DavidBorsky/NODI-Robotic-Alarm-Clock/Analysis/actuator_torque_analysis.pdf

0.00 | 0.01 | 0.02 | 0.03 | 0.04 | 0.05
| | | Torque [N·m]

### Pitch demand (SF = 2)

### Yaw demand (SF = 2)

### Assumed operating budget

0.0347 N·m

0.0136 N·m

0.0441 N·m

## Actuator sizing — analytical screening

Budget = 25% of MG90S 4.8 V stall torque; designer assumption, not a continuous rating. CAD mass +25%, 5 g head wiring, 10 mm CG offset, 180°/s². No hardware test.
