DavidBorsky/NODI-Robotic-Alarm-Clock/Analysis/command_motion_profiles.pdf

−20

0

20

### Angle [°]

# Full-travel quintic command profiles — calculated

0

20

40

60

### Velocity [°/s]

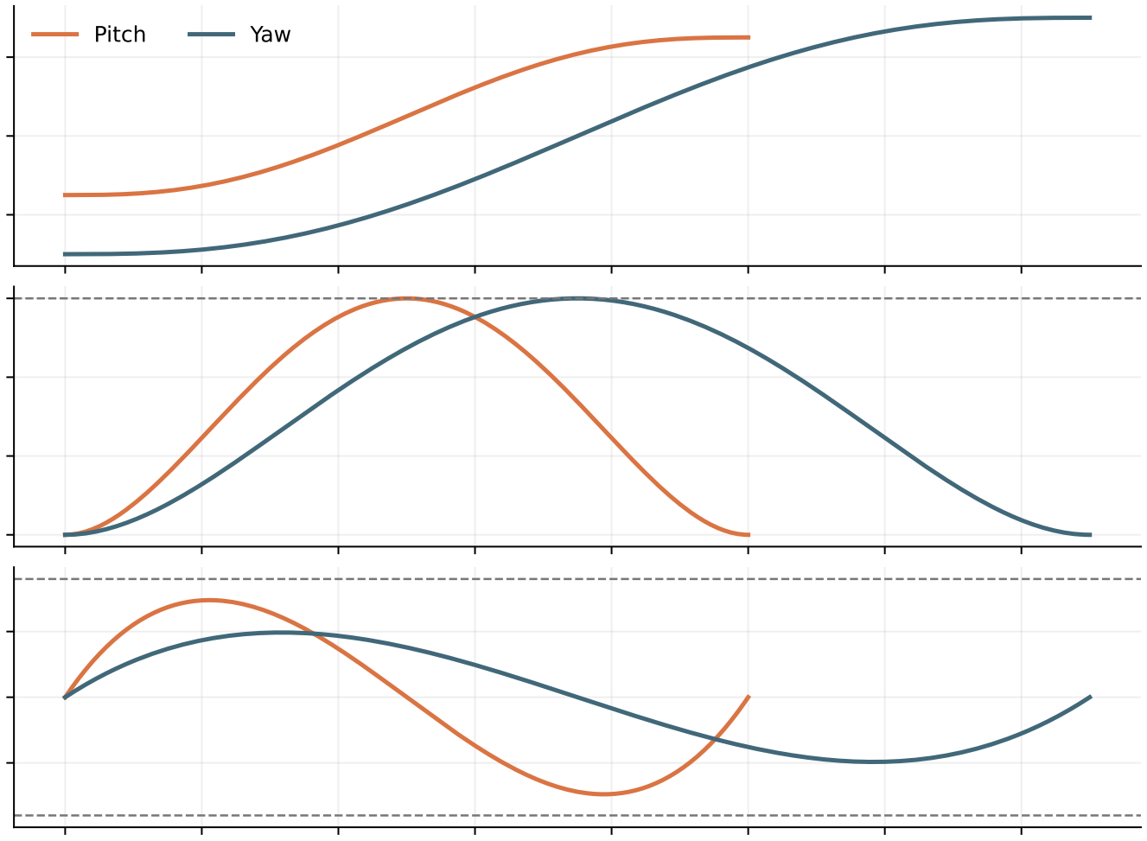
[picture p9: figure]
Pitch; Yaw

0.00 | 0.25 | 0.50 | 0.75 | 1.00 | 1.25 | 1.50 | 1.75
| | | | Time [s]

−100

0

100

### Acceleration [°/s²]

Command trajectories only. Loaded servo position, speed, backlash and current remain unmeasured.
