DavidBorsky/NODI-Robotic-Alarm-Clock/CAD/Kinematics/solver_motion.csv

frame | time_s | yaw_deg | yaw_origin_error_mm | yaw_axis_error_deg | pitch_deg | pitch_origin_error_mm | pitch_axis_error_deg | phase
1 | 0.0 | 0.0 | 0.0 | 0.0 | 0.0 | 0.0 | 0.0 | Neutral
2 | 0.016666666666666666 | 0.0 | 0.0 | 0.0 | 0.0 | 0.0 | 0.0 | Neutral
3 | 0.03333333333333333 | 0.0 | 0.0 | 0.0 | 0.0 | 0.0 | 0.0 | Neutral
4 | 0.05 | 0.0 | 0.0 | 0.0 | 0.0 | 0.0 | 0.0 | Neutral
5 | 0.06666666666666667 | 0.0 | 0.0 | 0.0 | 0.0 | 0.0 | 0.0 | Neutral
6 | 0.08333333333333333 | 0.0 | 0.0 | 0.0 | 0.0 | 0.0 | 0.0 | Neutral
7 | 0.1 | 0.0 | 0.0 | 0.0 | 0.0 | 0.0 | 0.0 | Neutral
8 | 0.11666666666666667 | 0.0 | 0.0 | 0.0 | 0.0 | 0.0 | 0.0 | Neutral
9 | 0.13333333333333333 | 0.0 | 0.0 | 0.0 | 0.0 | 0.0 | 0.0 | Neutral
10 | 0.15 | 0.0 | 0.0 | 0.0 | 0.0 | 0.0 | 0.0 | Neutral
11 | 0.16666666666666666 | 0.0 | 0.0 | 0.0 | 0.0 | 0.0 | 0.0 | Neutral
12 | 0.18333333333333332 | 0.0 | 0.0 | 0.0 | 0.0 | 0.0 | 0.0 | Neutral
13 | 0.2 | 0.0 | 0.0 | 0.0 | 0.0 | 0.0 | 0.0 | Neutral
14 | 0.21666666666666667 | 0.0 | 0.0 | 0.0 | 0.0 | 0.0 | 0.0 | Neutral
15 | 0.23333333333333334 | 0.0 | 0.0 | 0.0 | 0.0 | 0.0 | 0.0 | Neutral
16 | 0.25 | 0.0 | 0.0 | 0.0 | 0.0 | 0.0 | 0.0 | Neutral
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
