DavidBorsky/NODI-Robotic-Alarm-Clock/Images/actuator_torque_analysis.png

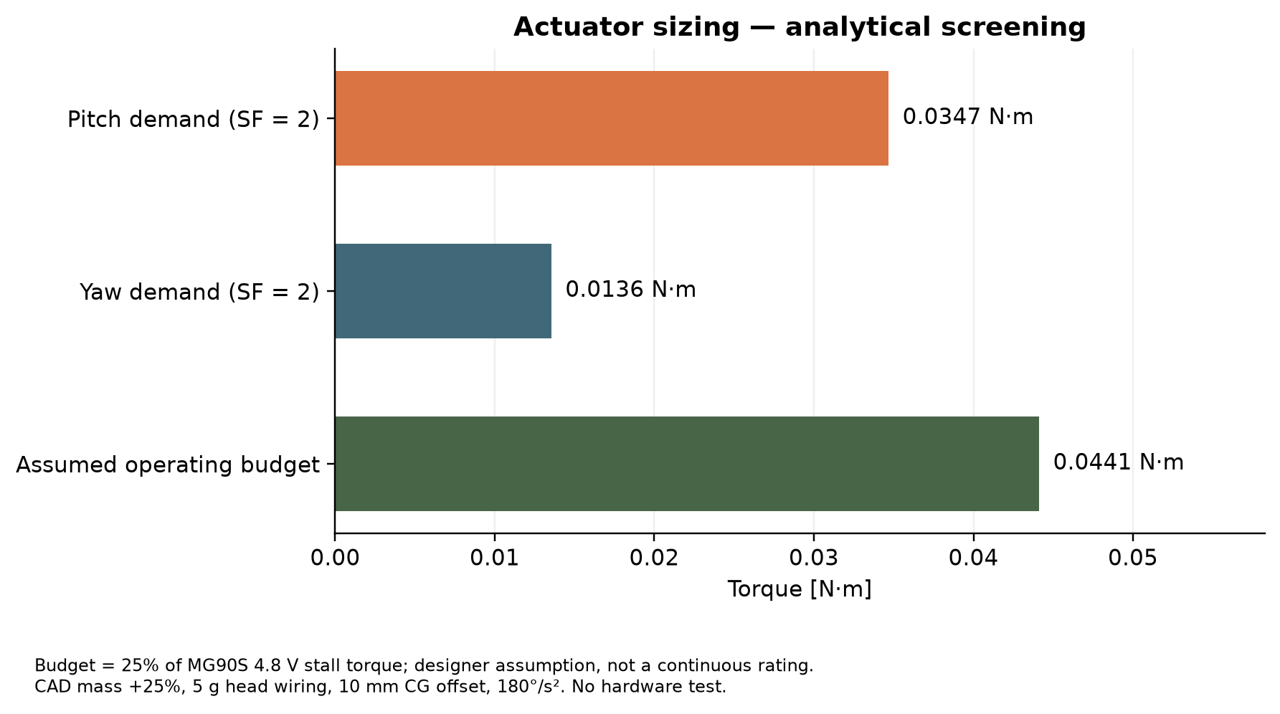
Images/actuator_torque_analysis.png
