DavidBorsky/NODI-Robotic-Alarm-Clock/Images/command_motion_profiles.png

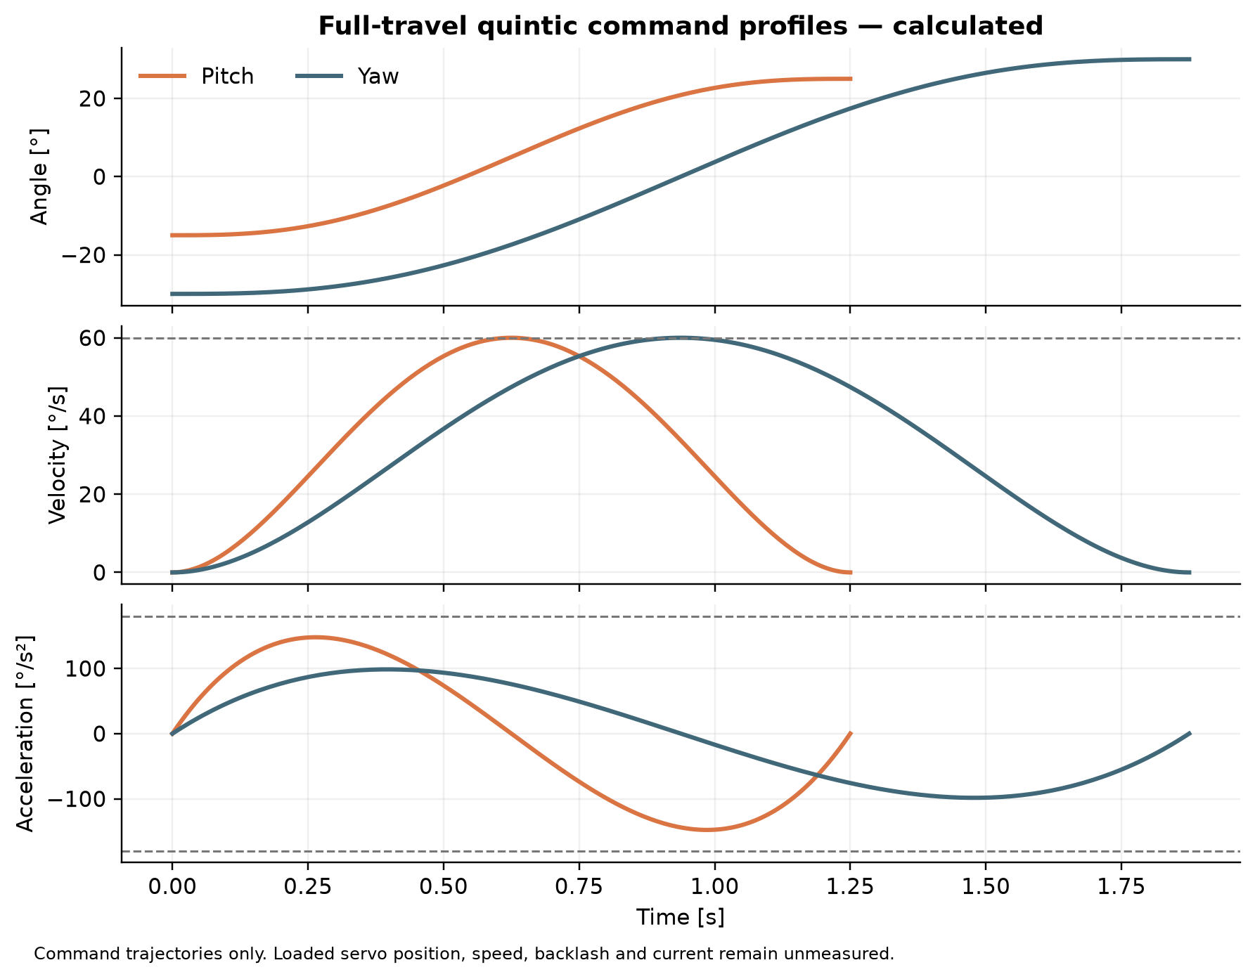
Images/command_motion_profiles.png
