DavidBorsky/NODI-Robotic-Alarm-Clock/Images/nodi_cheerful.png

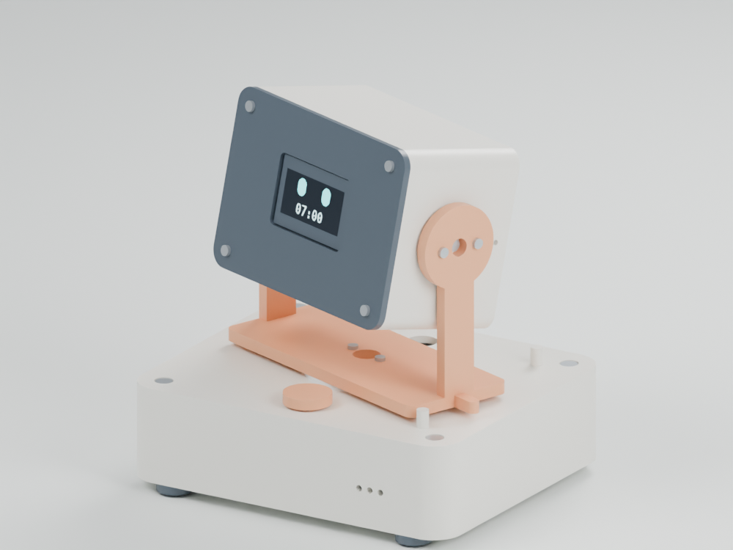
Images/nodi_cheerful.png
