DavidBorsky/NODI-Robotic-Alarm-Clock/Images/nodi_cutaway.png

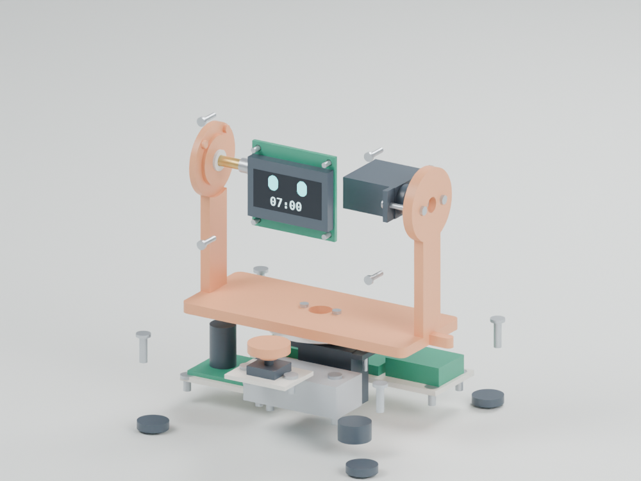
Images/nodi_cutaway.png
