DavidBorsky/NODI-Robotic-Alarm-Clock/Images/nodi_top.png

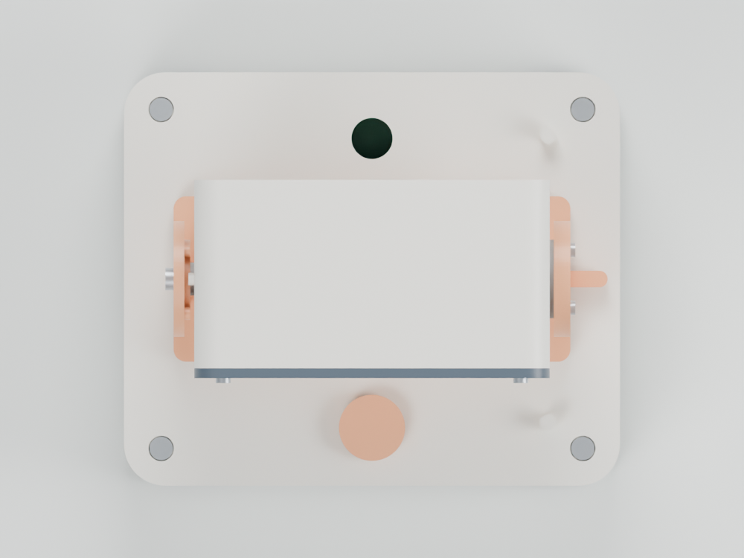
Images/nodi_top.png
