DavidBorsky/NODI-Robotic-Alarm-Clock/CAD/exports/NODI_Assembly_RevA.step

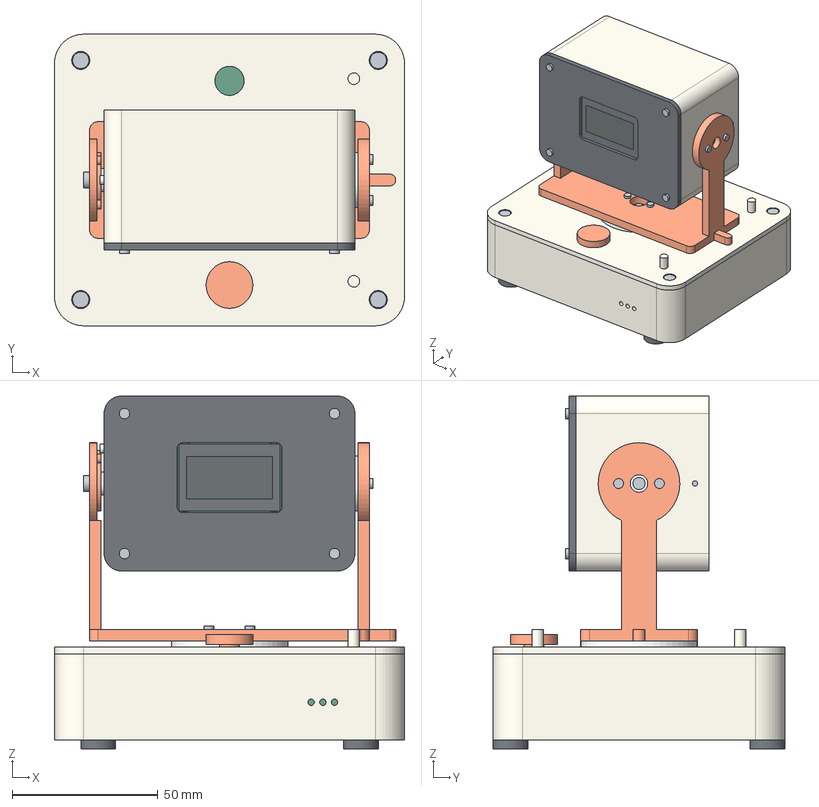
[picture p15: CAD file, 2026-10-25]
CAD/exports/NODI_Assembly_RevA.step
120.0 x 100.0 x 121.0 mm
base_cup
base_deck
thrust_washer
yoke
head_shell
front_bezel
pan_servo
tilt_servo
pan_horn
tilt_horn
pan_retaining_screw
tilt_retaining_screw
pitch_sleeve
pitch_washer
pitch_bolt
pitch_nut
oled_pcb
oled_panel
oled_active
rear_carrier
power_carrier
pico
rtc
power_perfboard
capacitor
buffer_ic
switch_carrier
snooze_switch
snooze_cap
piezo
foot_1
foot_2
foot_3
foot_4
ballast
ballast_screw_1
ballast_screw_2
deck_screw_1
deck_screw_2
deck_screw_3
deck_screw_4
bezel_screw_1
bezel_screw_2
bezel_screw_3
bezel_screw_4
oled_screw_1
oled_screw_2
oled_screw_3
oled_screw_4
pan_mount_screw_1
pan_mount_screw_2
tilt_mount_screw_1
tilt_mount_screw_2
pan_horn_screw_1
pan_horn_screw_2
tilt_horn_screw_1
tilt_horn_screw_2
rear_screw_1
rear_screw_2
rear_screw_3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
