DavidBorsky/NODI-Robotic-Alarm-Clock/CAD/exports/STL/NODI-P02_base_deck.stl

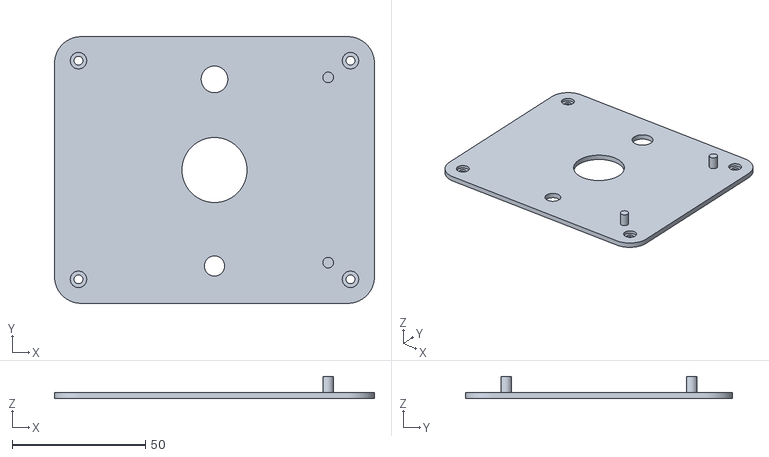
[picture p16: CAD file, 2026-10-25]
CAD/exports/STL/NODI-P02_base_deck.stl
120.0 x 100.0 x 8.40
