DavidBorsky/NODI-Robotic-Alarm-Clock/CAD/exports/STEP/snooze_switch.step

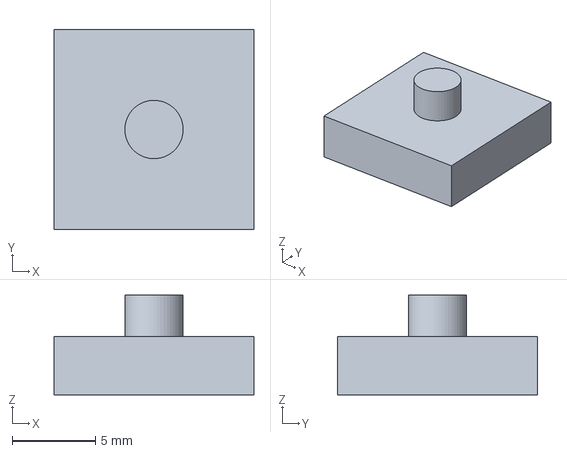
[picture p18: CAD file, 2026-10-25]
CAD/exports/STEP/snooze_switch.step
12.0 x 12.0 x 6.00 mm
