DavidBorsky/NODI-Robotic-Alarm-Clock/CAD/exports/STL/NODI-P06_rear_carrier.stl

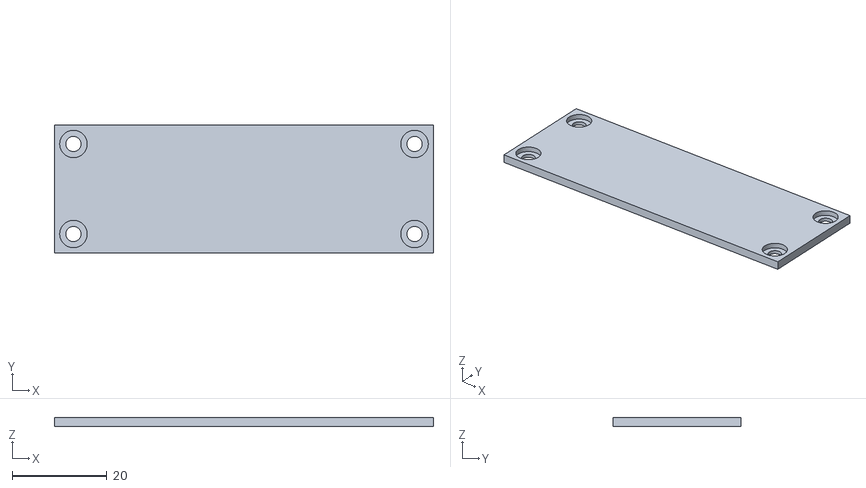
[picture p19: CAD file, 2026-10-25]
CAD/exports/STL/NODI-P06_rear_carrier.stl
80.0 x 27.0 x 2.00
