DavidBorsky/NODI-Robotic-Alarm-Clock/CAD/exports/meshes/tilt_servo.stl

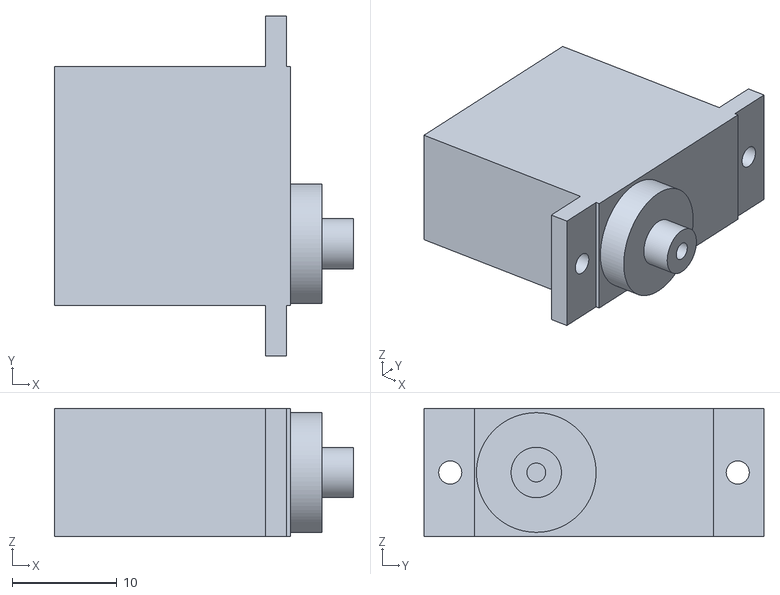
[picture p20: CAD file, 2026-10-25]
CAD/exports/meshes/tilt_servo.stl
28.5 x 32.4 x 12.2
