DavidBorsky/NODI-Robotic-Alarm-Clock/CAD/exports/STEP/power_perfboard.step

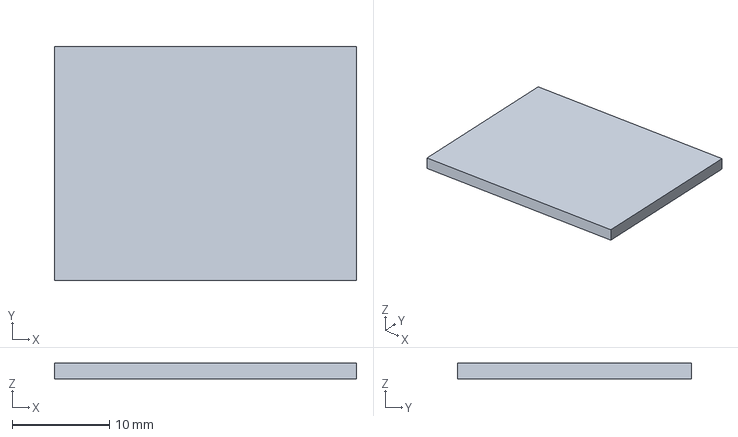
[picture p21: CAD file, 2026-10-25]
CAD/exports/STEP/power_perfboard.step
31.0 x 24.0 x 1.60 mm
