DavidBorsky/NODI-Robotic-Alarm-Clock/CAD/exports/STL/NODI-P09_snooze_cap.stl

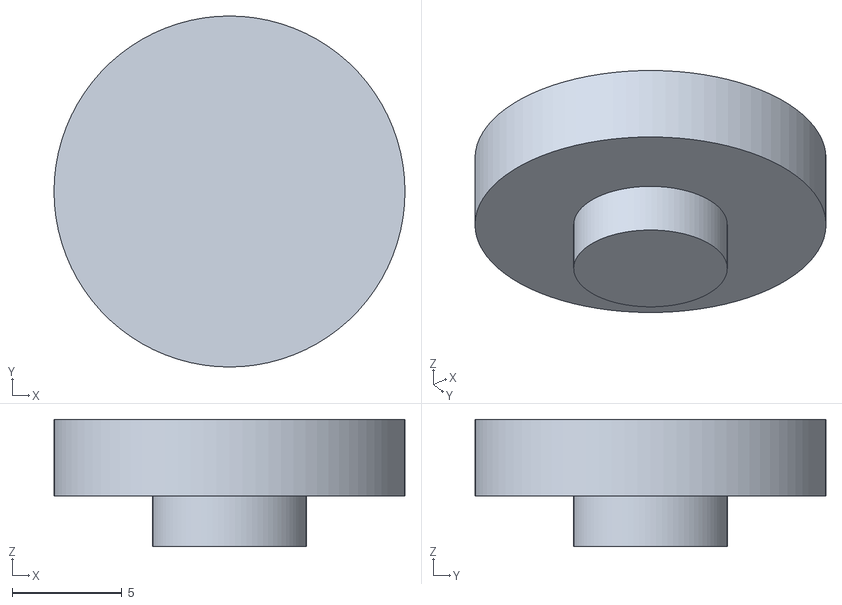
[picture p22: CAD file, 2026-10-25]
CAD/exports/STL/NODI-P09_snooze_cap.stl
16.0 x 16.0 x 5.80
