DavidBorsky/NODI-Robotic-Alarm-Clock/CAD/exports/STEP/switch_carrier.step

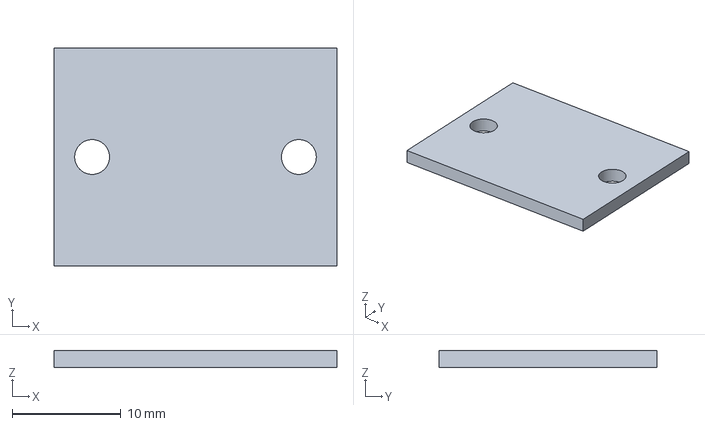
[picture p23: CAD file, 2026-10-25]
CAD/exports/STEP/switch_carrier.step
26.0 x 20.0 x 1.60 mm
