DavidBorsky/NODI-Robotic-Alarm-Clock/CAD/exports/STL/NODI-P01_base_cup.stl

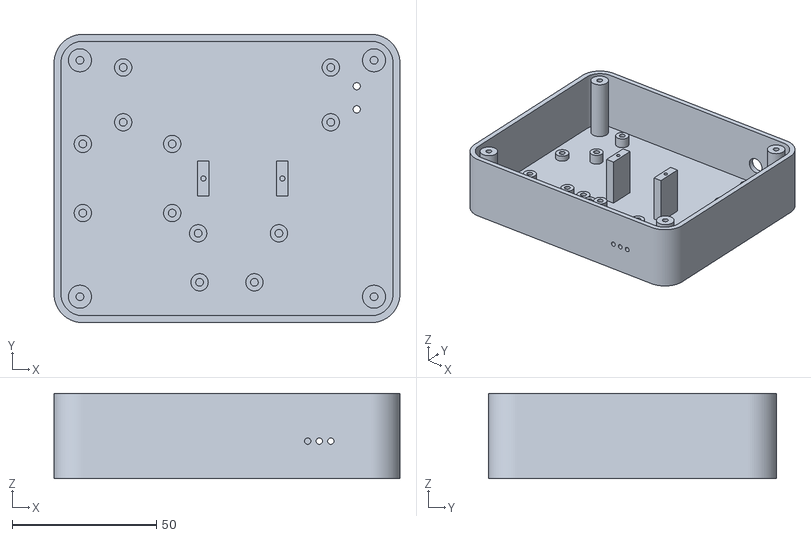
[picture p24: CAD file, 2026-10-25]
CAD/exports/STL/NODI-P01_base_cup.stl
120.0 x 100.0 x 29.6
