DavidBorsky/NODI-Robotic-Alarm-Clock/CAD/exports/STL/NODI-P07_power_carrier.stl

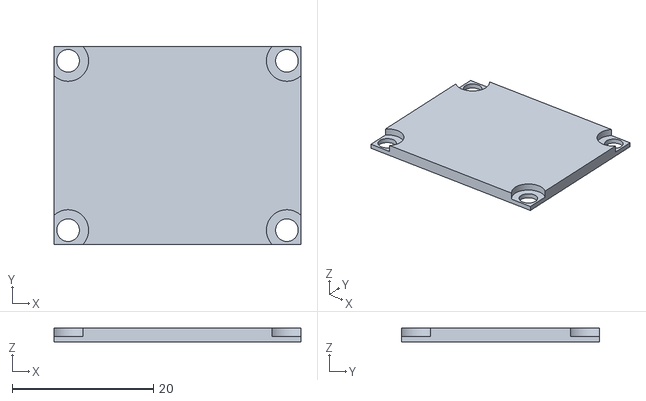
[picture p25: CAD file, 2026-10-25]
CAD/exports/STL/NODI-P07_power_carrier.stl
35.0 x 28.0 x 2.00
