DavidBorsky/NODI-Robotic-Alarm-Clock/CAD/exports/meshes/oled_active.stl

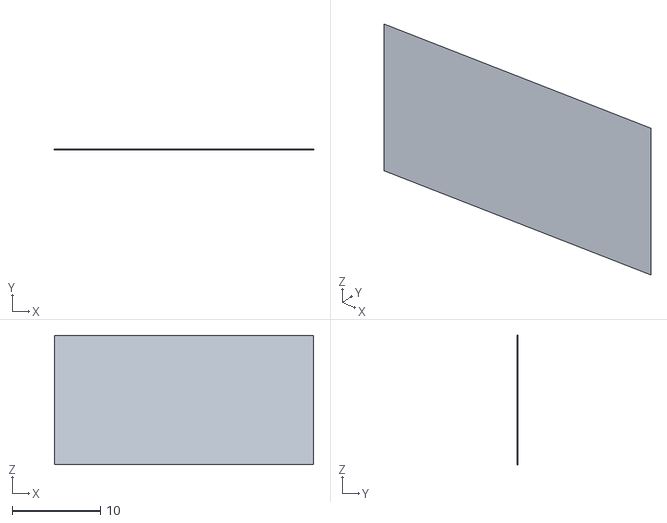
[picture p26: CAD file, 2026-10-25]
CAD/exports/meshes/oled_active.stl
29.4 x 0.03 x 14.7
