DavidBorsky/NODI-Robotic-Alarm-Clock/CAD/exports/STEP/piezo.step

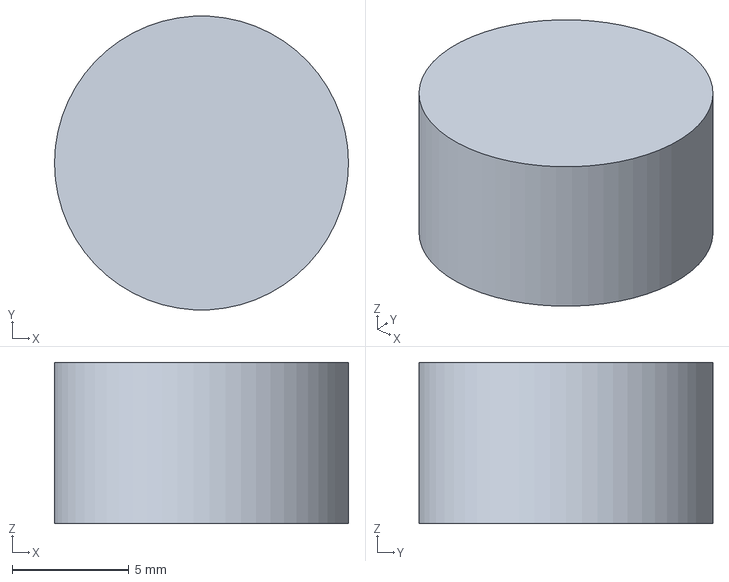
[picture p27: CAD file, 2026-10-25]
CAD/exports/STEP/piezo.step
12.6 x 12.6 x 6.90 mm
