DavidBorsky/NODI-Robotic-Alarm-Clock/CAD/exports/STL/NODI-P04_head_shell.stl

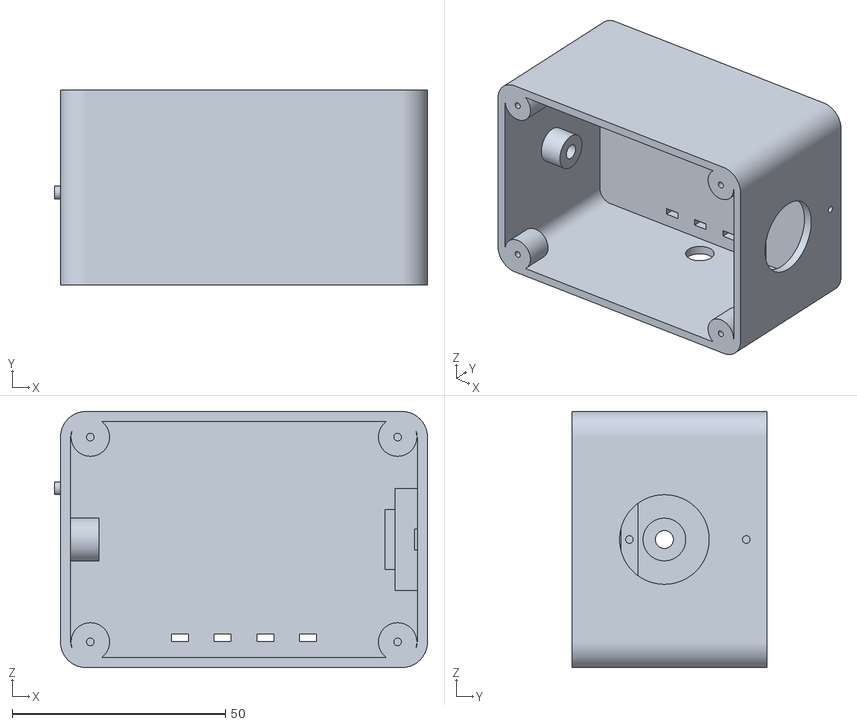
[picture p28: CAD file, 2026-10-25]
CAD/exports/STL/NODI-P04_head_shell.stl
87.4 x 45.6 x 60.0
