DavidBorsky/NODI-Robotic-Alarm-Clock/CAD/exports/STL/NODI-P03_yoke.stl

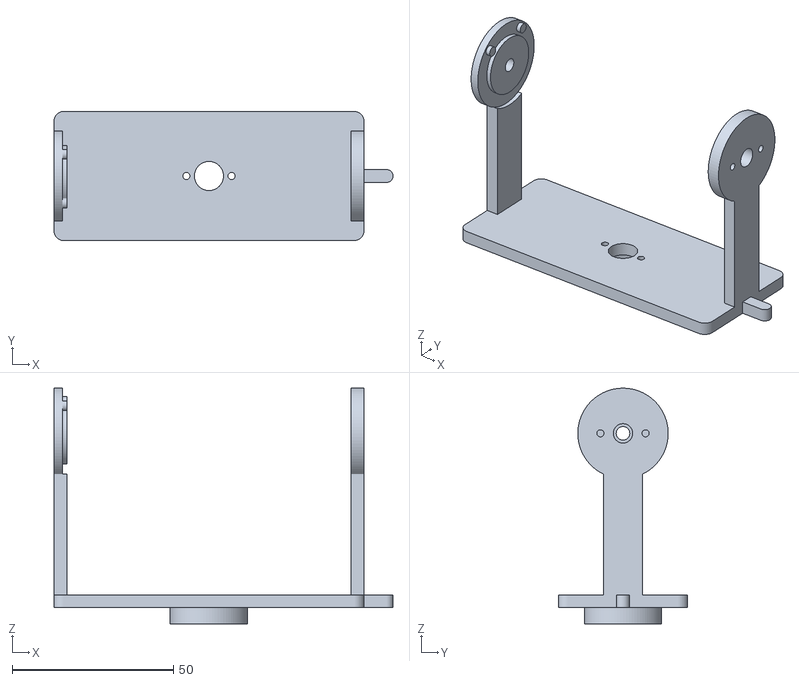
[picture p29: CAD file, 2026-10-25]
CAD/exports/STL/NODI-P03_yoke.stl
105.0 x 40.0 x 73.0
