DavidBorsky/NODI-Robotic-Alarm-Clock/CAD/exports/STEP/ballast.step

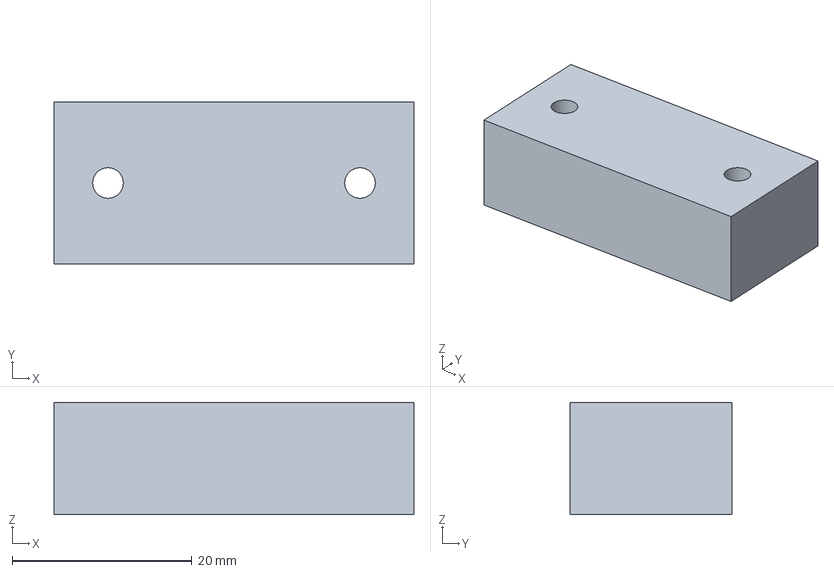
[picture p30: CAD file, 2026-10-25]
CAD/exports/STEP/ballast.step
40.0 x 18.0 x 12.5 mm
