DavidBorsky/NODI-Robotic-Alarm-Clock/CAD/exports/STL/NODI-P05_front_bezel.stl

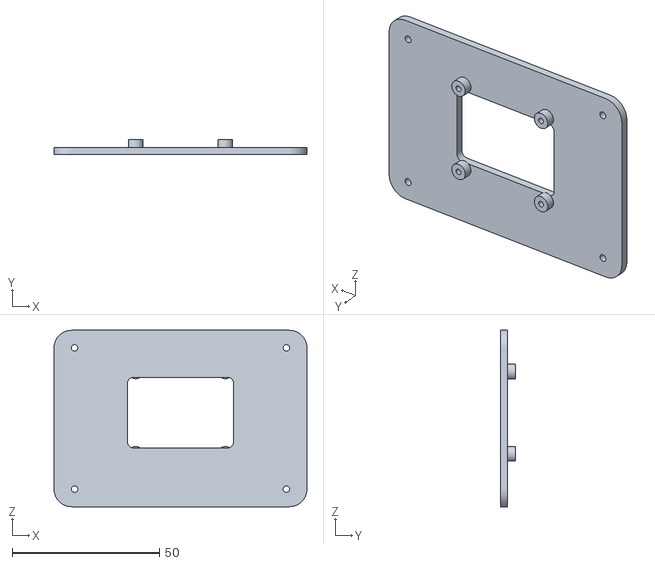
[picture p31: CAD file, 2026-10-25]
CAD/exports/STL/NODI-P05_front_bezel.stl
86.0 x 5.10 x 60.0
