DavidBorsky/NODI-Robotic-Alarm-Clock/CAD/exports/meshes/foot_1.stl

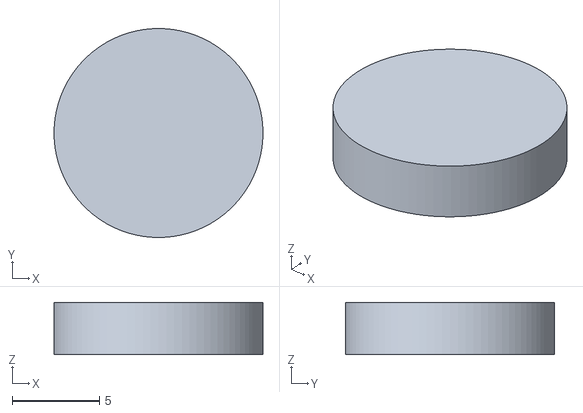
[picture p32: CAD file, 2026-10-25]
CAD/exports/meshes/foot_1.stl
12.0 x 12.0 x 3.00
