DavidBorsky/NODI-Robotic-Alarm-Clock/CAD/exports/meshes/pitch_sleeve.stl

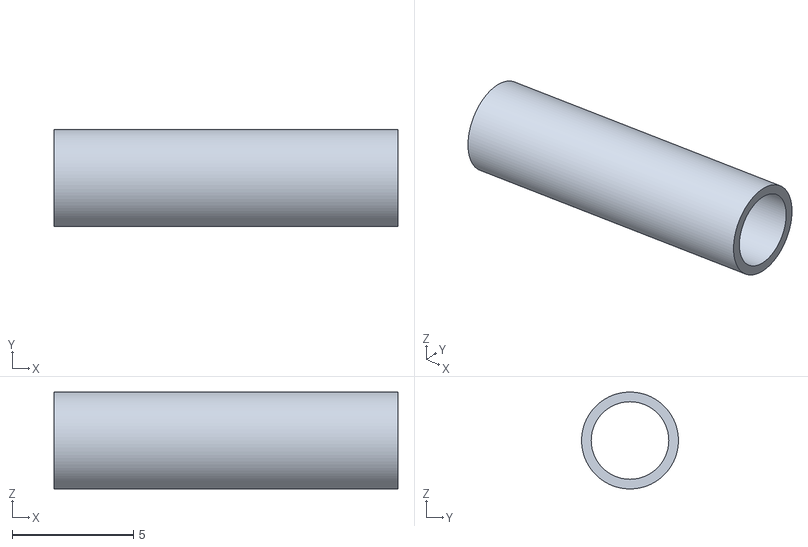
[picture p33: CAD file, 2026-10-25]
CAD/exports/meshes/pitch_sleeve.stl
14.2 x 4.00 x 4.00
