DavidBorsky/NODI-Robotic-Alarm-Clock/CAD/exports/meshes/oled_pcb.stl

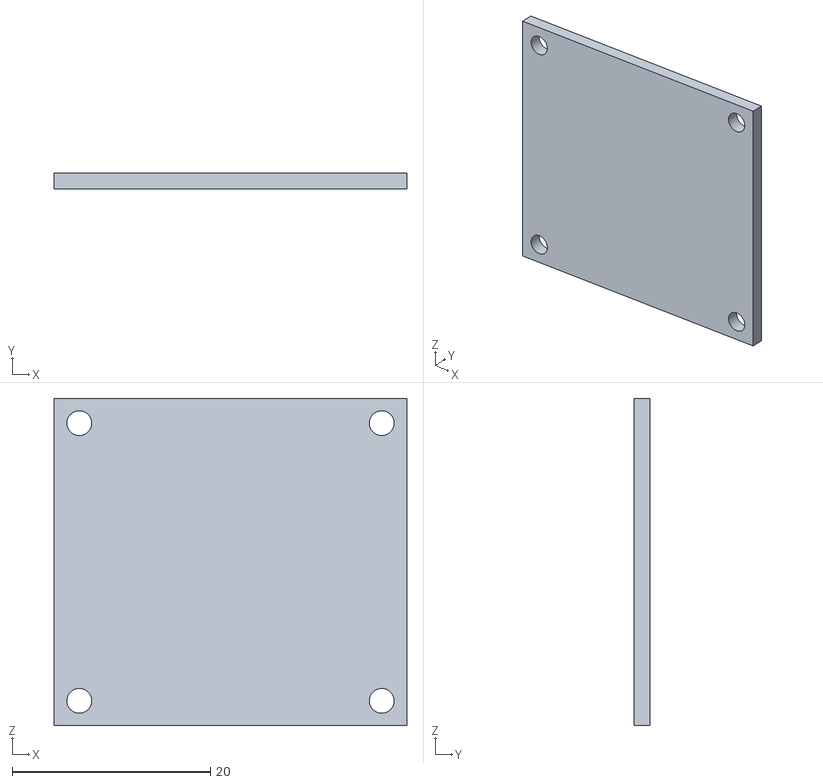
[picture p34: CAD file, 2026-10-25]
CAD/exports/meshes/oled_pcb.stl
35.6 x 1.60 x 33.0
