DavidBorsky/NODI-Robotic-Alarm-Clock/CAD/exports/STEP/tilt_horn.step

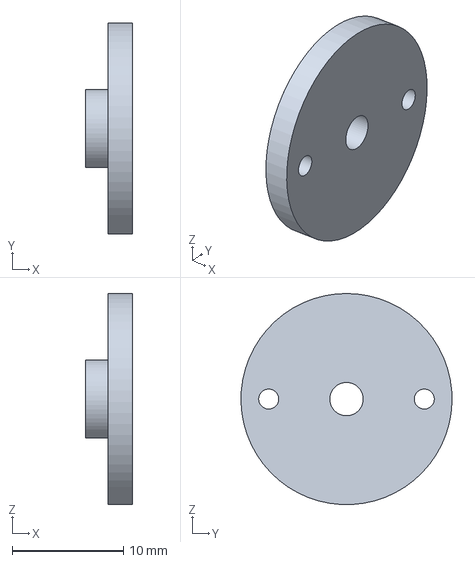
[picture p35: CAD file, 2026-10-25]
CAD/exports/STEP/tilt_horn.step
4.20 x 19.0 x 19.0 mm
