DavidBorsky/NODI-Robotic-Alarm-Clock/CAD/exports/meshes/pico.stl

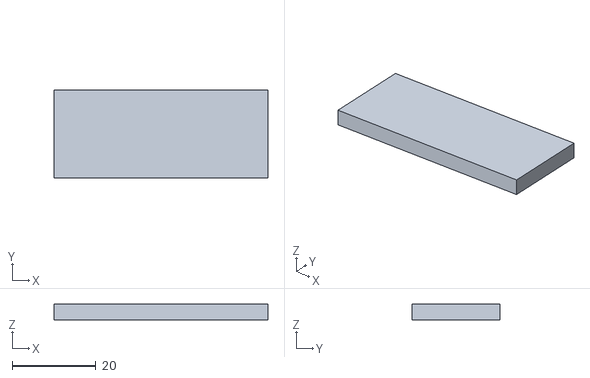
[picture p36: CAD file, 2026-10-25]
CAD/exports/meshes/pico.stl
51.0 x 21.0 x 3.80
