DavidBorsky/NODI-Robotic-Alarm-Clock/CAD/exports/STEP/pan_horn.step

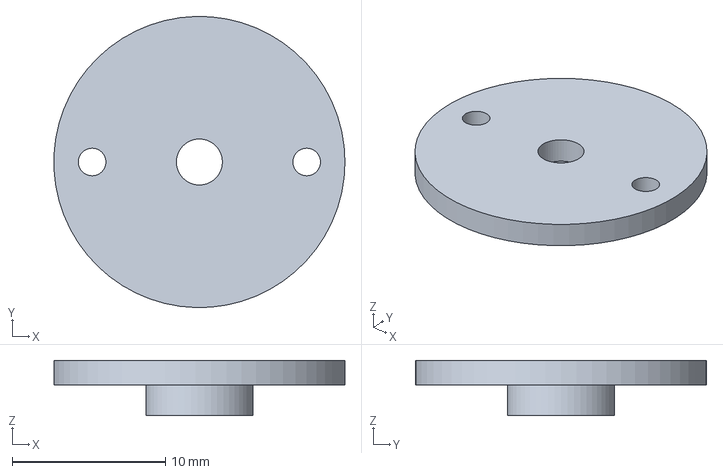
[picture p37: CAD file, 2026-10-25]
CAD/exports/STEP/pan_horn.step
19.0 x 19.0 x 3.60 mm
