DavidBorsky/NODI-Robotic-Alarm-Clock/CAD/exports/meshes/oled_panel.stl

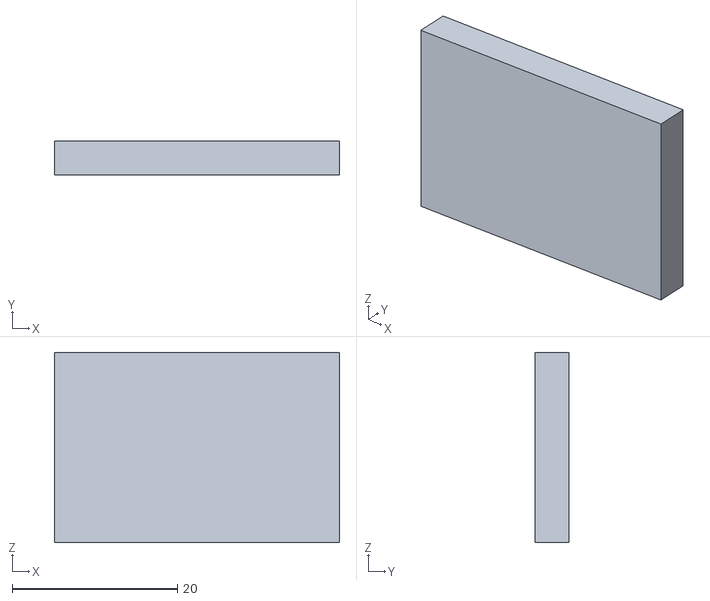
[picture p38: CAD file, 2026-10-25]
CAD/exports/meshes/oled_panel.stl
34.5 x 4.10 x 23.0
