DavidBorsky/NODI-Robotic-Alarm-Clock/CAD/exports/STEP/rtc.step

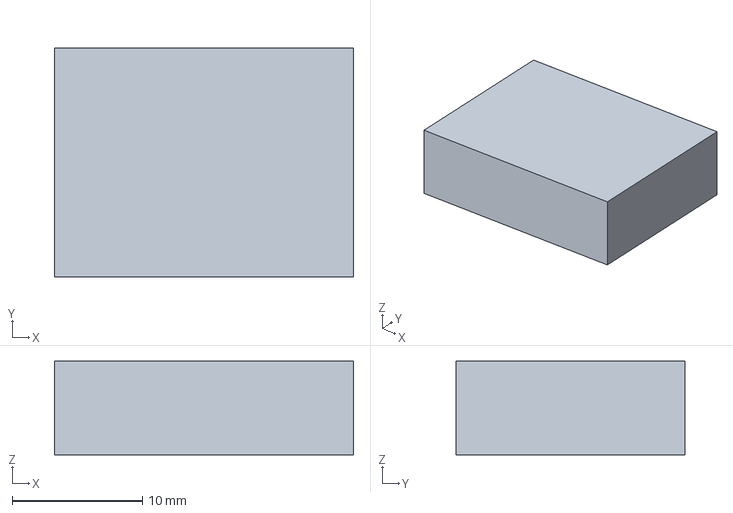
[picture p39: CAD file, 2026-10-25]
CAD/exports/STEP/rtc.step
23.0 x 17.6 x 7.20 mm
