DavidBorsky/NODI-Robotic-Alarm-Clock/CAD/exports/STEP/buffer_ic.step

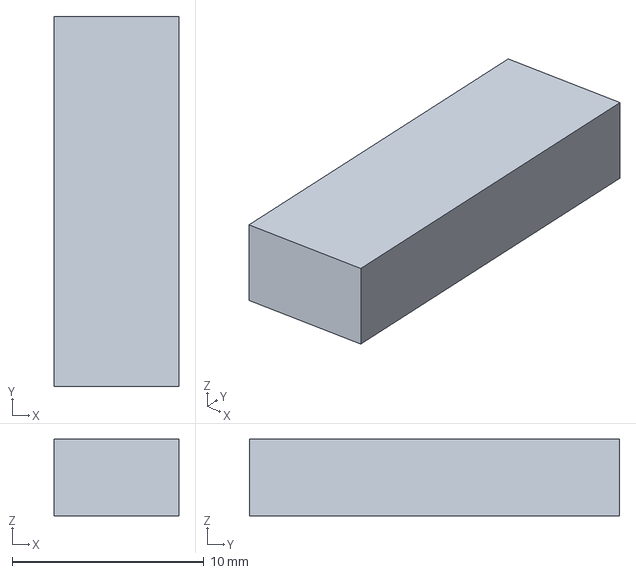
[picture p40: CAD file, 2026-10-25]
CAD/exports/STEP/buffer_ic.step
6.50 x 19.3 x 4.00 mm
