DavidBorsky/NODI-Robotic-Alarm-Clock/CAD/exports/meshes/pan_servo.stl

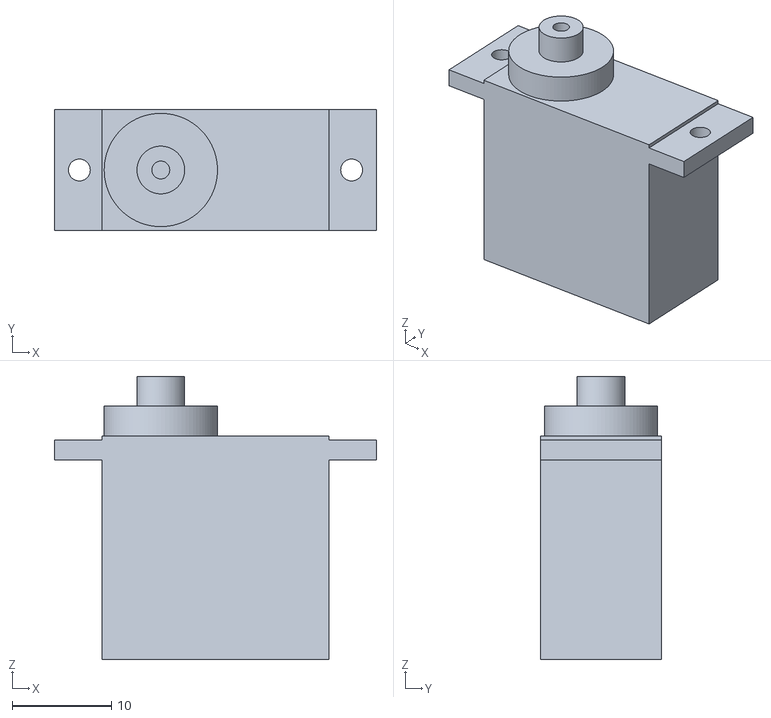
[picture p41: CAD file, 2026-10-25]
CAD/exports/meshes/pan_servo.stl
32.4 x 12.2 x 28.5
