DavidBorsky/NODI-Robotic-Alarm-Clock/CAD/exports/meshes/pan_horn.stl

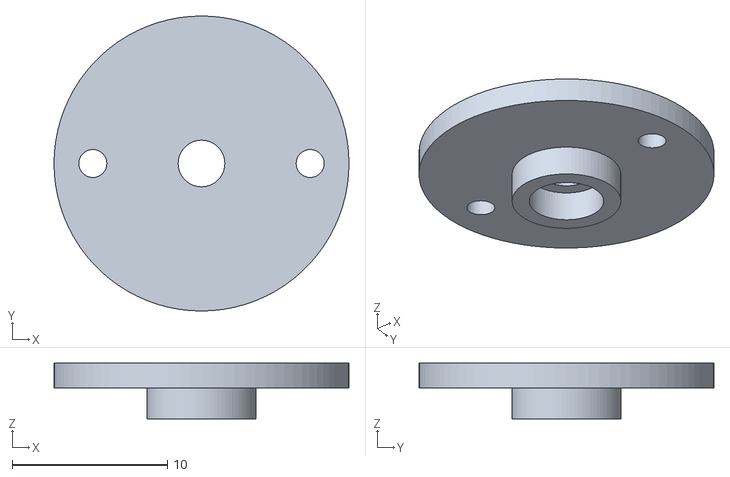
[picture p42: CAD file, 2026-10-25]
CAD/exports/meshes/pan_horn.stl
19.0 x 19.0 x 3.60
