DavidBorsky/NODI-Robotic-Alarm-Clock/CAD/exports/meshes/capacitor.stl

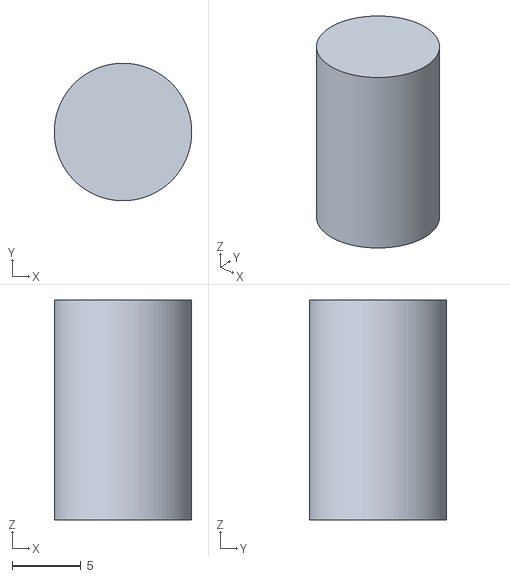
[picture p43: CAD file, 2026-10-25]
CAD/exports/meshes/capacitor.stl
10.0 x 10.0 x 16.0
