DavidBorsky/NODI-Robotic-Alarm-Clock/(list of files, cad)

Other CAD files:
CAD/exports/STL/NODI-P08_switch_carrier.stl
CAD/exports/STEP/oled_active.step
CAD/exports/meshes/ballast.stl
CAD/exports/meshes/base_cup.stl
CAD/exports/STEP/head_shell.step
CAD/exports/STEP/foot_2.step
CAD/exports/meshes/rear_carrier.stl
CAD/exports/STEP/rear_carrier.step
CAD/exports/STEP/front_bezel.step
CAD/exports/meshes/tilt_horn.stl
CAD/exports/STEP/yoke.step
CAD/exports/meshes/piezo.stl
CAD/exports/STEP/pan_servo.step
CAD/exports/meshes/front_bezel.stl
CAD/exports/STEP/foot_4.step
CAD/exports/meshes/snooze_switch.stl
CAD/exports/STEP/power_carrier.step
CAD/exports/meshes/foot_2.stl
CAD/exports/STEP/snooze_cap.step
CAD/exports/meshes/base_deck.stl
CAD/exports/STEP/base_deck.step
CAD/exports/meshes/power_perfboard.stl
CAD/exports/meshes/head_shell.stl
CAD/exports/meshes/snooze_cap.stl
CAD/exports/meshes/rtc.stl
CAD/exports/meshes/buffer_ic.stl
CAD/exports/meshes/foot_4.stl
CAD/exports/STEP/oled_pcb.step
CAD/exports/STEP/tilt_servo.step
CAD/exports/meshes/switch_carrier.stl
CAD/exports/STEP/pitch_sleeve.step
CAD/exports/STEP/pico.step
CAD/exports/meshes/power_carrier.stl
CAD/exports/STEP/foot_1.step
CAD/exports/meshes/foot_3.stl
CAD/exports/STEP/foot_3.step
CAD/exports/meshes/yoke.stl
CAD/exports/STEP/oled_panel.step
CAD/exports/STEP/capacitor.step
CAD/exports/STEP/base_cup.step
CAD/Kinematics/NODI_Articulated_RevA.blend
CAD/exports/STEP/ballast_screw_1.step
CAD/exports/STEP/ballast_screw_2.step
CAD/exports/STEP/bezel_screw_1.step
CAD/exports/STEP/bezel_screw_2.step
CAD/exports/STEP/bezel_screw_3.step
CAD/exports/STEP/bezel_screw_4.step
CAD/exports/STEP/deck_screw_1.step
CAD/exports/STEP/deck_screw_2.step
CAD/exports/STEP/deck_screw_3.step
CAD/exports/STEP/deck_screw_4.step
CAD/exports/STEP/oled_screw_1.step
CAD/exports/STEP/oled_screw_2.step
CAD/exports/STEP/oled_screw_3.step
CAD/exports/STEP/oled_screw_4.step
CAD/exports/STEP/pan_horn_screw_1.step
CAD/exports/STEP/pan_horn_screw_2.step
CAD/exports/STEP/pan_mount_screw_1.step
CAD/exports/STEP/pan_mount_screw_2.step
CAD/exports/STEP/pan_retaining_screw.step
CAD/exports/STEP/pitch_bolt.step
CAD/exports/STEP/pitch_nut.step
CAD/exports/STEP/pitch_washer.step
CAD/exports/STEP/power_screw_1.step
CAD/exports/STEP/power_screw_2.step
CAD/exports/STEP/power_screw_3.step
CAD/exports/STEP/power_screw_4.step
CAD/exports/STEP/rear_screw_1.step
CAD/exports/STEP/rear_screw_2.step
CAD/exports/STEP/rear_screw_3.step
CAD/exports/STEP/rear_screw_4.step
CAD/exports/STEP/switch_screw_1.step
CAD/exports/STEP/switch_screw_2.step
CAD/exports/STEP/thrust_washer.step
CAD/exports/STEP/tilt_horn_screw_1.step
CAD/exports/STEP/tilt_horn_screw_2.step
CAD/exports/STEP/tilt_mount_screw_1.step
CAD/exports/STEP/tilt_mount_screw_2.step
CAD/exports/STEP/tilt_retaining_screw.step
CAD/exports/meshes/ballast_screw_1.stl
CAD/exports/meshes/ballast_screw_2.stl
CAD/exports/meshes/bezel_screw_1.stl
CAD/exports/meshes/bezel_screw_2.stl
CAD/exports/meshes/bezel_screw_3.stl
CAD/exports/meshes/bezel_screw_4.stl
CAD/exports/meshes/deck_screw_1.stl
CAD/exports/meshes/deck_screw_2.stl
CAD/exports/meshes/deck_screw_3.stl
CAD/exports/meshes/deck_screw_4.stl
CAD/exports/meshes/oled_screw_1.stl
CAD/exports/meshes/oled_screw_2.stl
CAD/exports/meshes/oled_screw_3.stl
CAD/exports/meshes/oled_screw_4.stl
CAD/exports/meshes/pan_horn_screw_1.stl
CAD/exports/meshes/pan_horn_screw_2.stl
CAD/exports/meshes/pan_mount_screw_1.stl
CAD/exports/meshes/pan_mount_screw_2.stl
CAD/exports/meshes/pan_retaining_screw.stl
CAD/exports/meshes/pitch_bolt.stl
CAD/exports/meshes/pitch_nut.stl
CAD/exports/meshes/pitch_washer.stl
CAD/exports/meshes/power_screw_1.stl
CAD/exports/meshes/power_screw_2.stl
CAD/exports/meshes/power_screw_3.stl
CAD/exports/meshes/power_screw_4.stl
CAD/exports/meshes/rear_screw_1.stl
CAD/exports/meshes/rear_screw_2.stl
CAD/exports/meshes/rear_screw_3.stl
CAD/exports/meshes/rear_screw_4.stl
CAD/exports/meshes/switch_screw_1.stl
CAD/exports/meshes/switch_screw_2.stl
CAD/exports/meshes/thrust_washer.stl
CAD/exports/meshes/tilt_horn_screw_1.stl
CAD/exports/meshes/tilt_horn_screw_2.stl
CAD/exports/meshes/tilt_mount_screw_1.stl
CAD/exports/meshes/tilt_mount_screw_2.stl
CAD/exports/meshes/tilt_retaining_screw.stl
CAD/nodi_render_scene.blend
