DavidBorsky/NODI-Robotic-Alarm-Clock/Electronics/Schematics/NODI_System_RevB.pdf

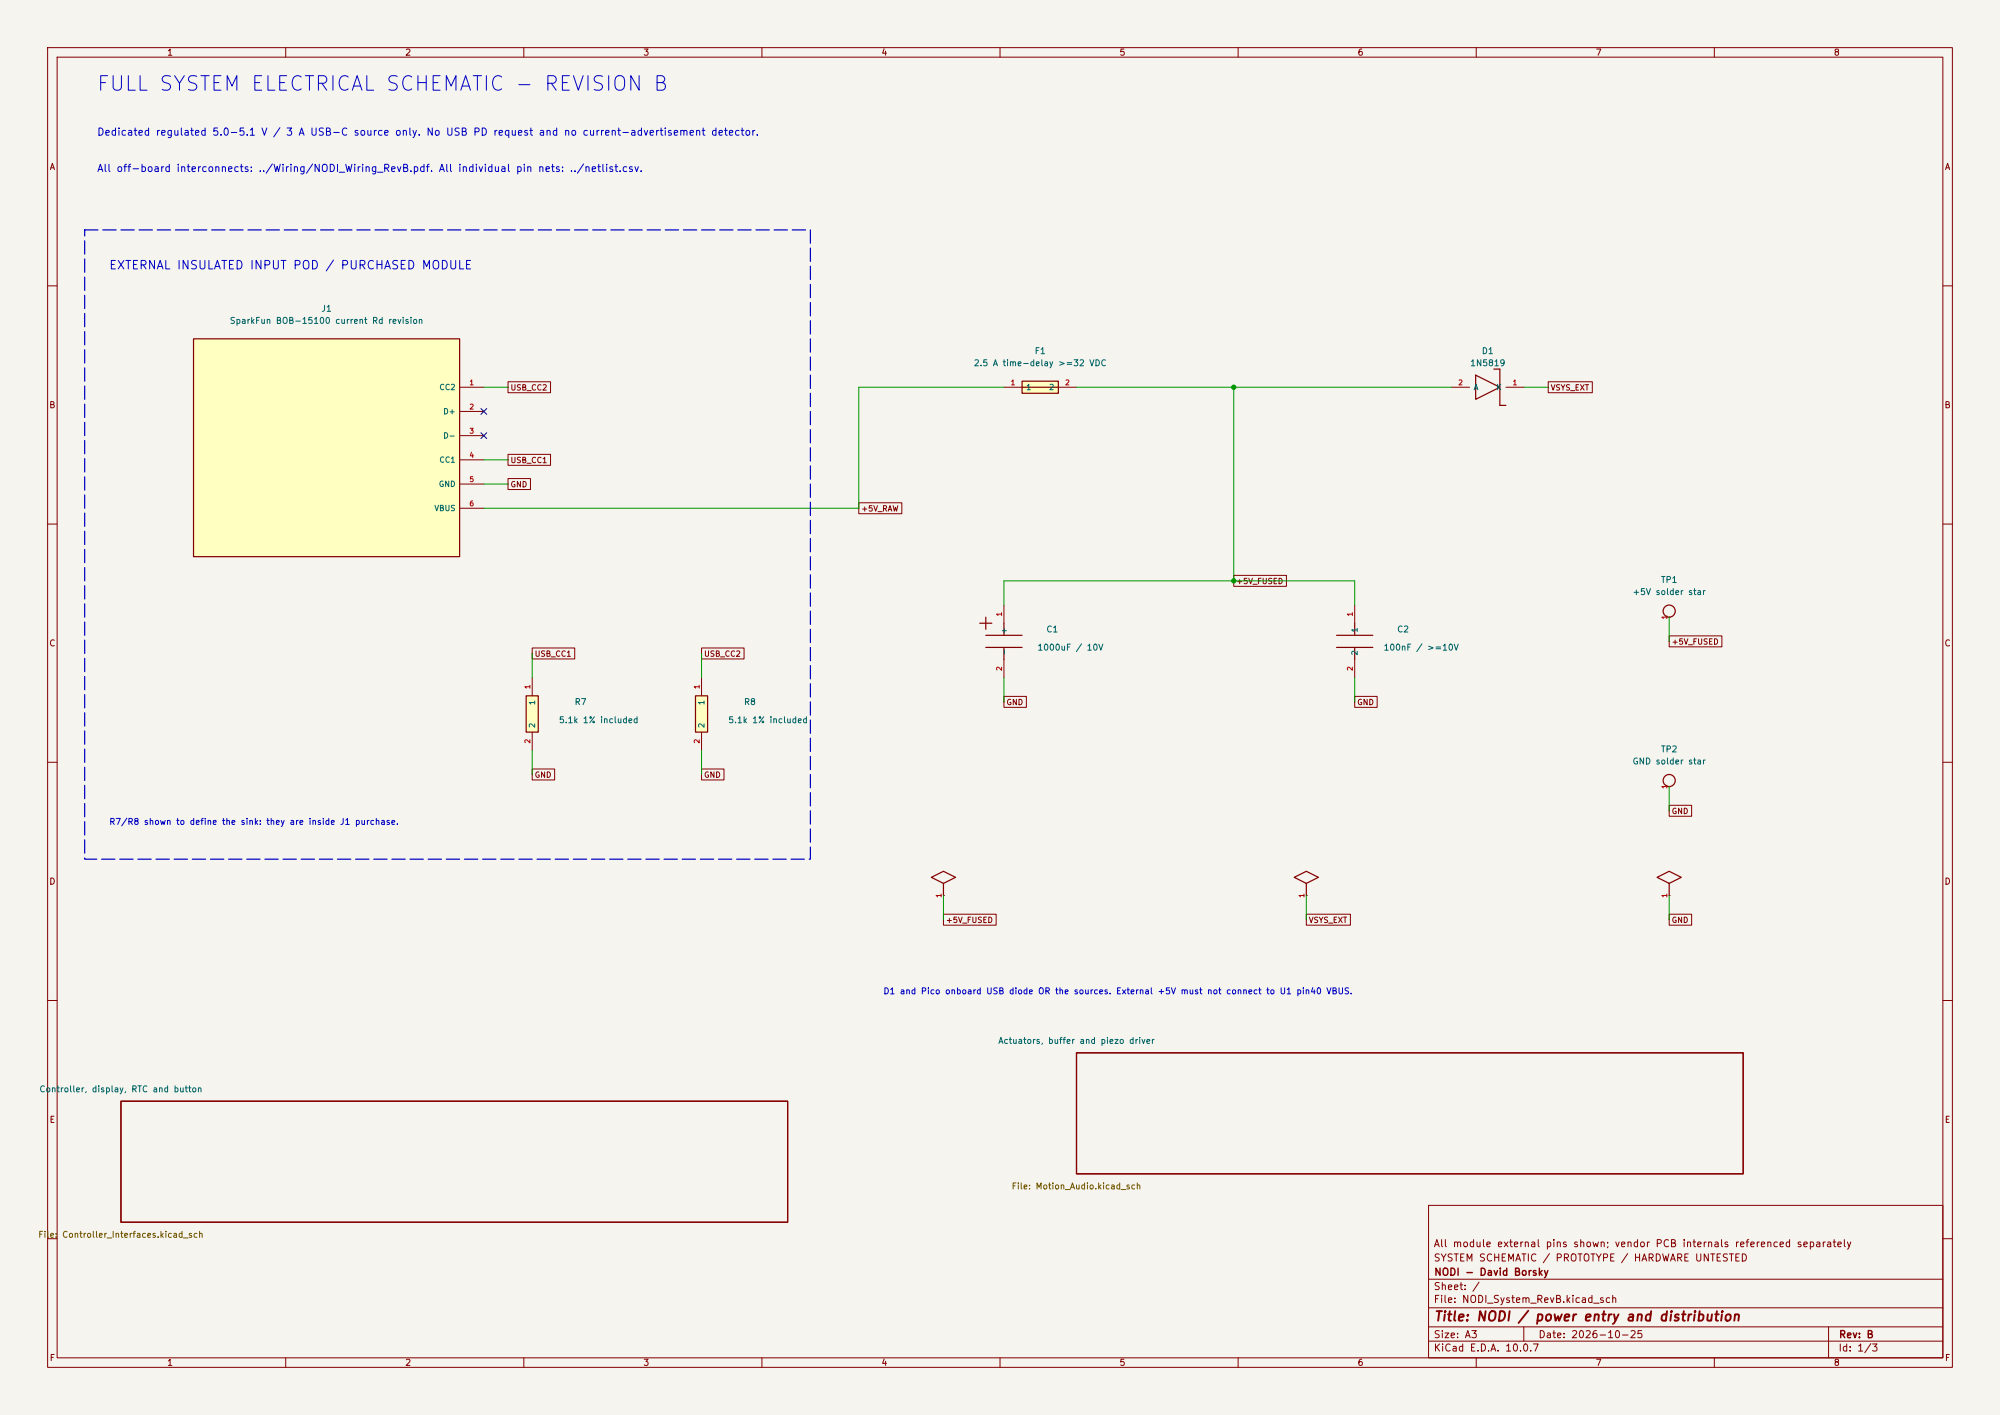
[picture p45: page 1]

FULL SYSTEM ELECTRICAL SCHEMATIC - REVISION B

Dedicated regulated 5.0-5.1 V / 3 A USB-C source only. No USB PD request and no current-advertisement detector.

All off-board interconnects: ../Wiring/NODI_Wiring_RevB.pdf. All individual pin nets: ../netlist.csv.

EXTERNAL INSULATED INPUT POD / PURCHASED MODULE

SparkFun BOB-15100 current Rd revision

D1 and Pico onboard USB diode OR the sources. External +5V must not connect to U1 pin40 VBUS. R7/R8 shown to define the sink: they are inside J1 purchase.

Actuators, buffer and piezo driver File: Motion_Audio.kicad_sch Controller, display, RTC and button

All module external pins shown; vendor PCB internals referenced separately
SYSTEM SCHEMATIC / PROTOTYPE / HARDWARE UNTESTED
NODI - David Borsky
Sheet: /
File: NODI_System_RevB.kicad_sch
Title: NODI / power entry and distribution

Size: A3 | Rev: B | F Date: 2026-10-25
KiCad E.D.A. 10.0.7 | Id: 1/3

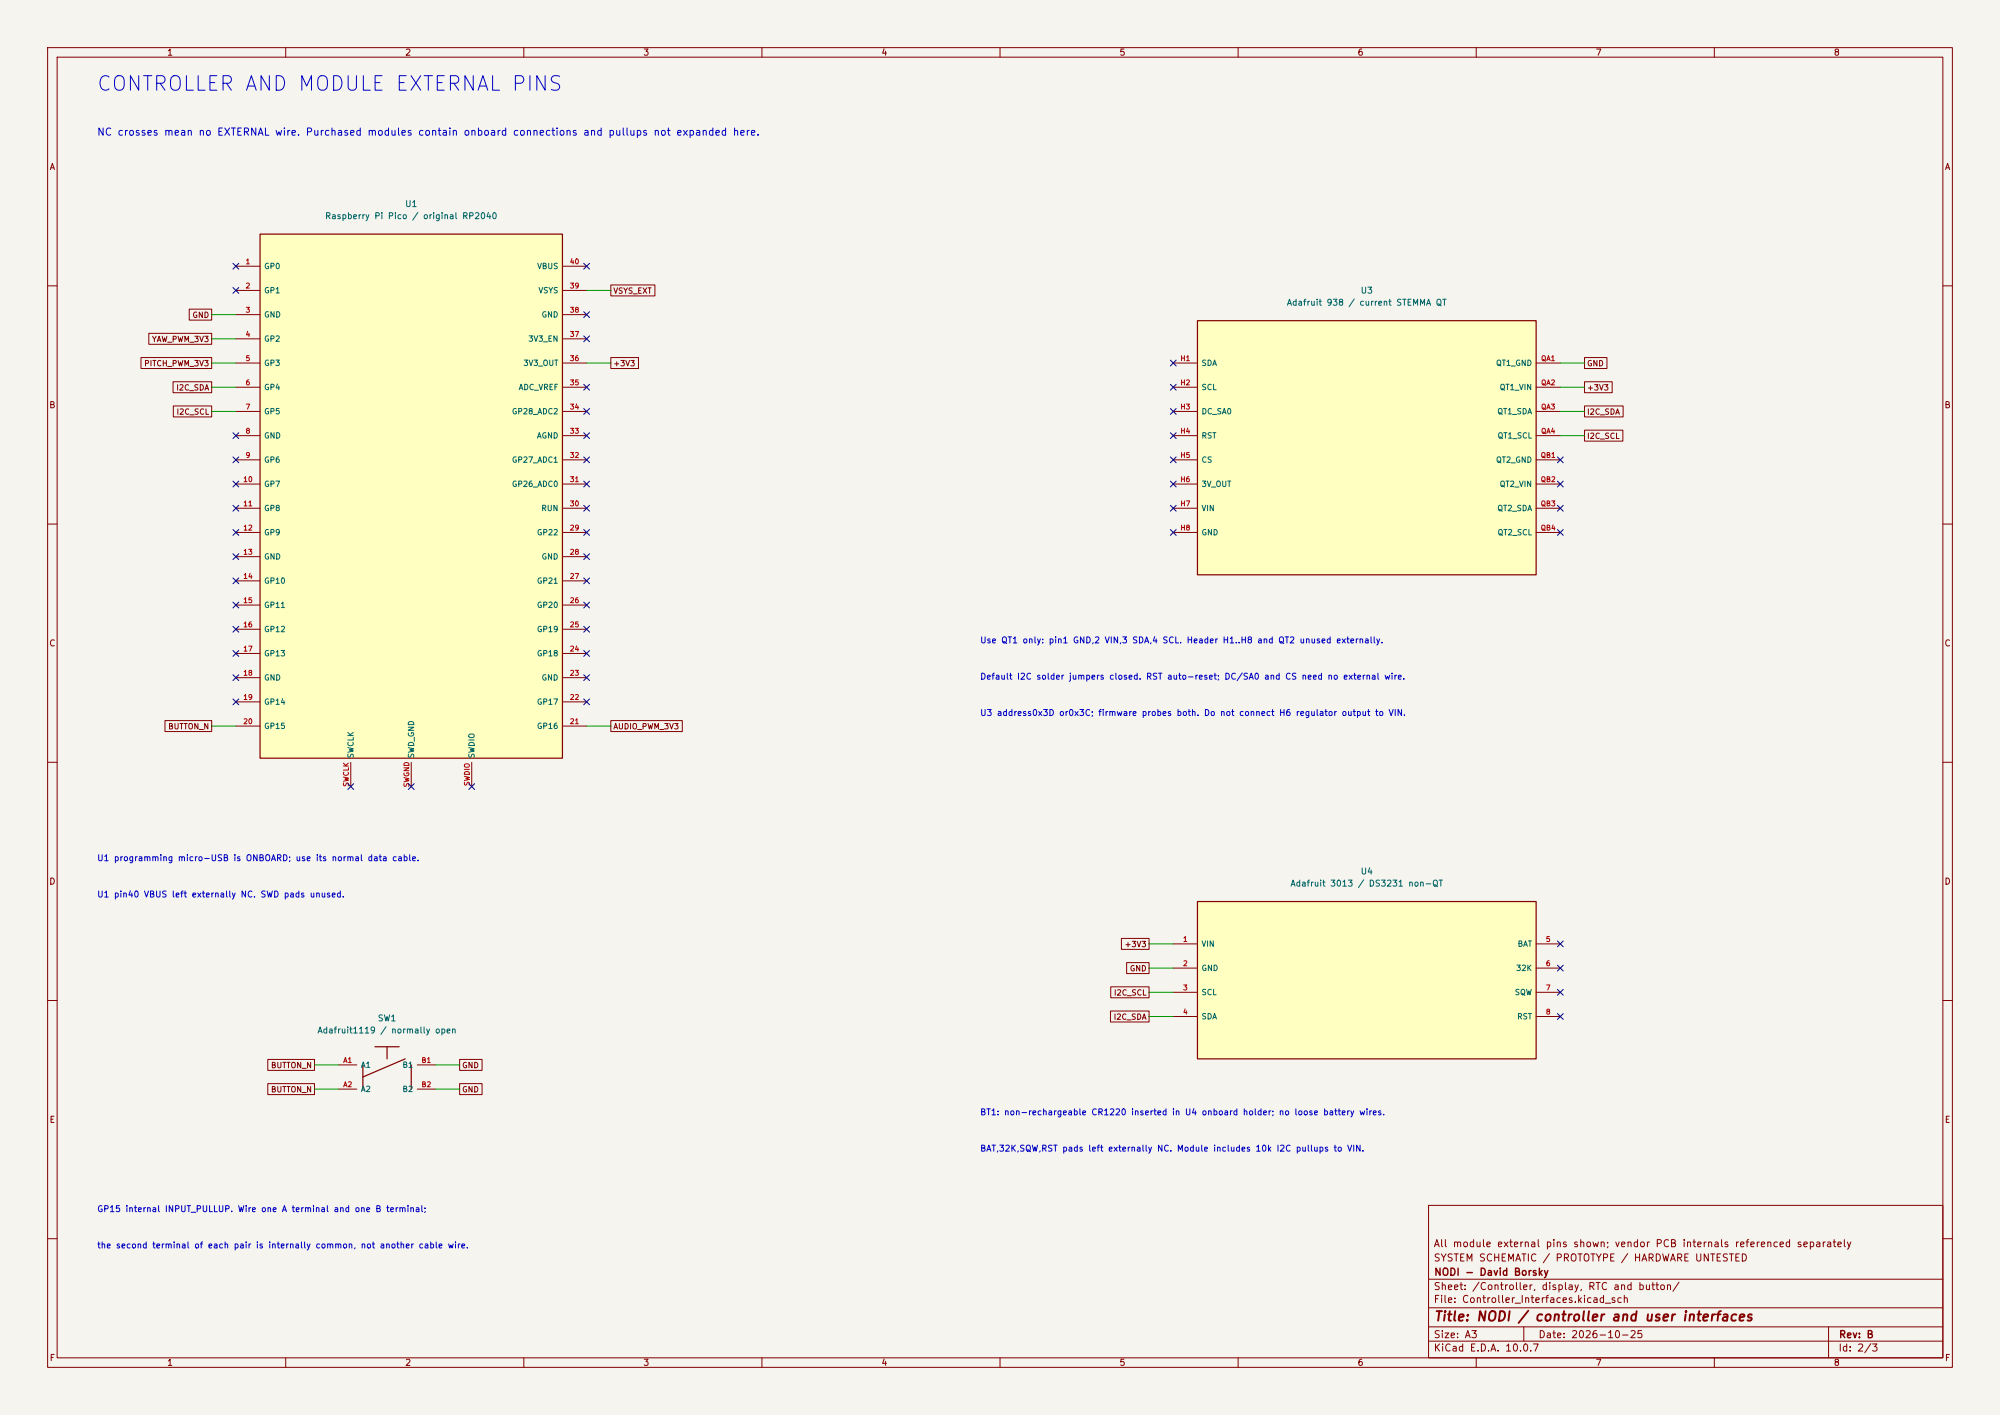
[picture p46: page 2]

CONTROLLER AND MODULE EXTERNAL PINS

NC crosses mean no EXTERNAL wire. Purchased modules contain onboard connections and pullups not expanded here.

Adafruit 938 / current STEMMA QT

U1 programming micro-USB is ONBOARD; use its normal data cable. U1 pin40 VBUS left externally NC. SWD pads unused. GP15 internal INPUT_PULLUP. Wire one A terminal and one B terminal;

BAT,32K,SQW,RST pads left externally NC. Module includes 10k I2C pullups to VIN.

All module external pins shown; vendor PCB internals referenced separately
SYSTEM SCHEMATIC / PROTOTYPE / HARDWARE UNTESTED
NODI - David Borsky
Sheet: /Controller, display, RTC and button/
File: Controller_Interfaces.kicad_sch
Title: NODI / controller and user interfaces

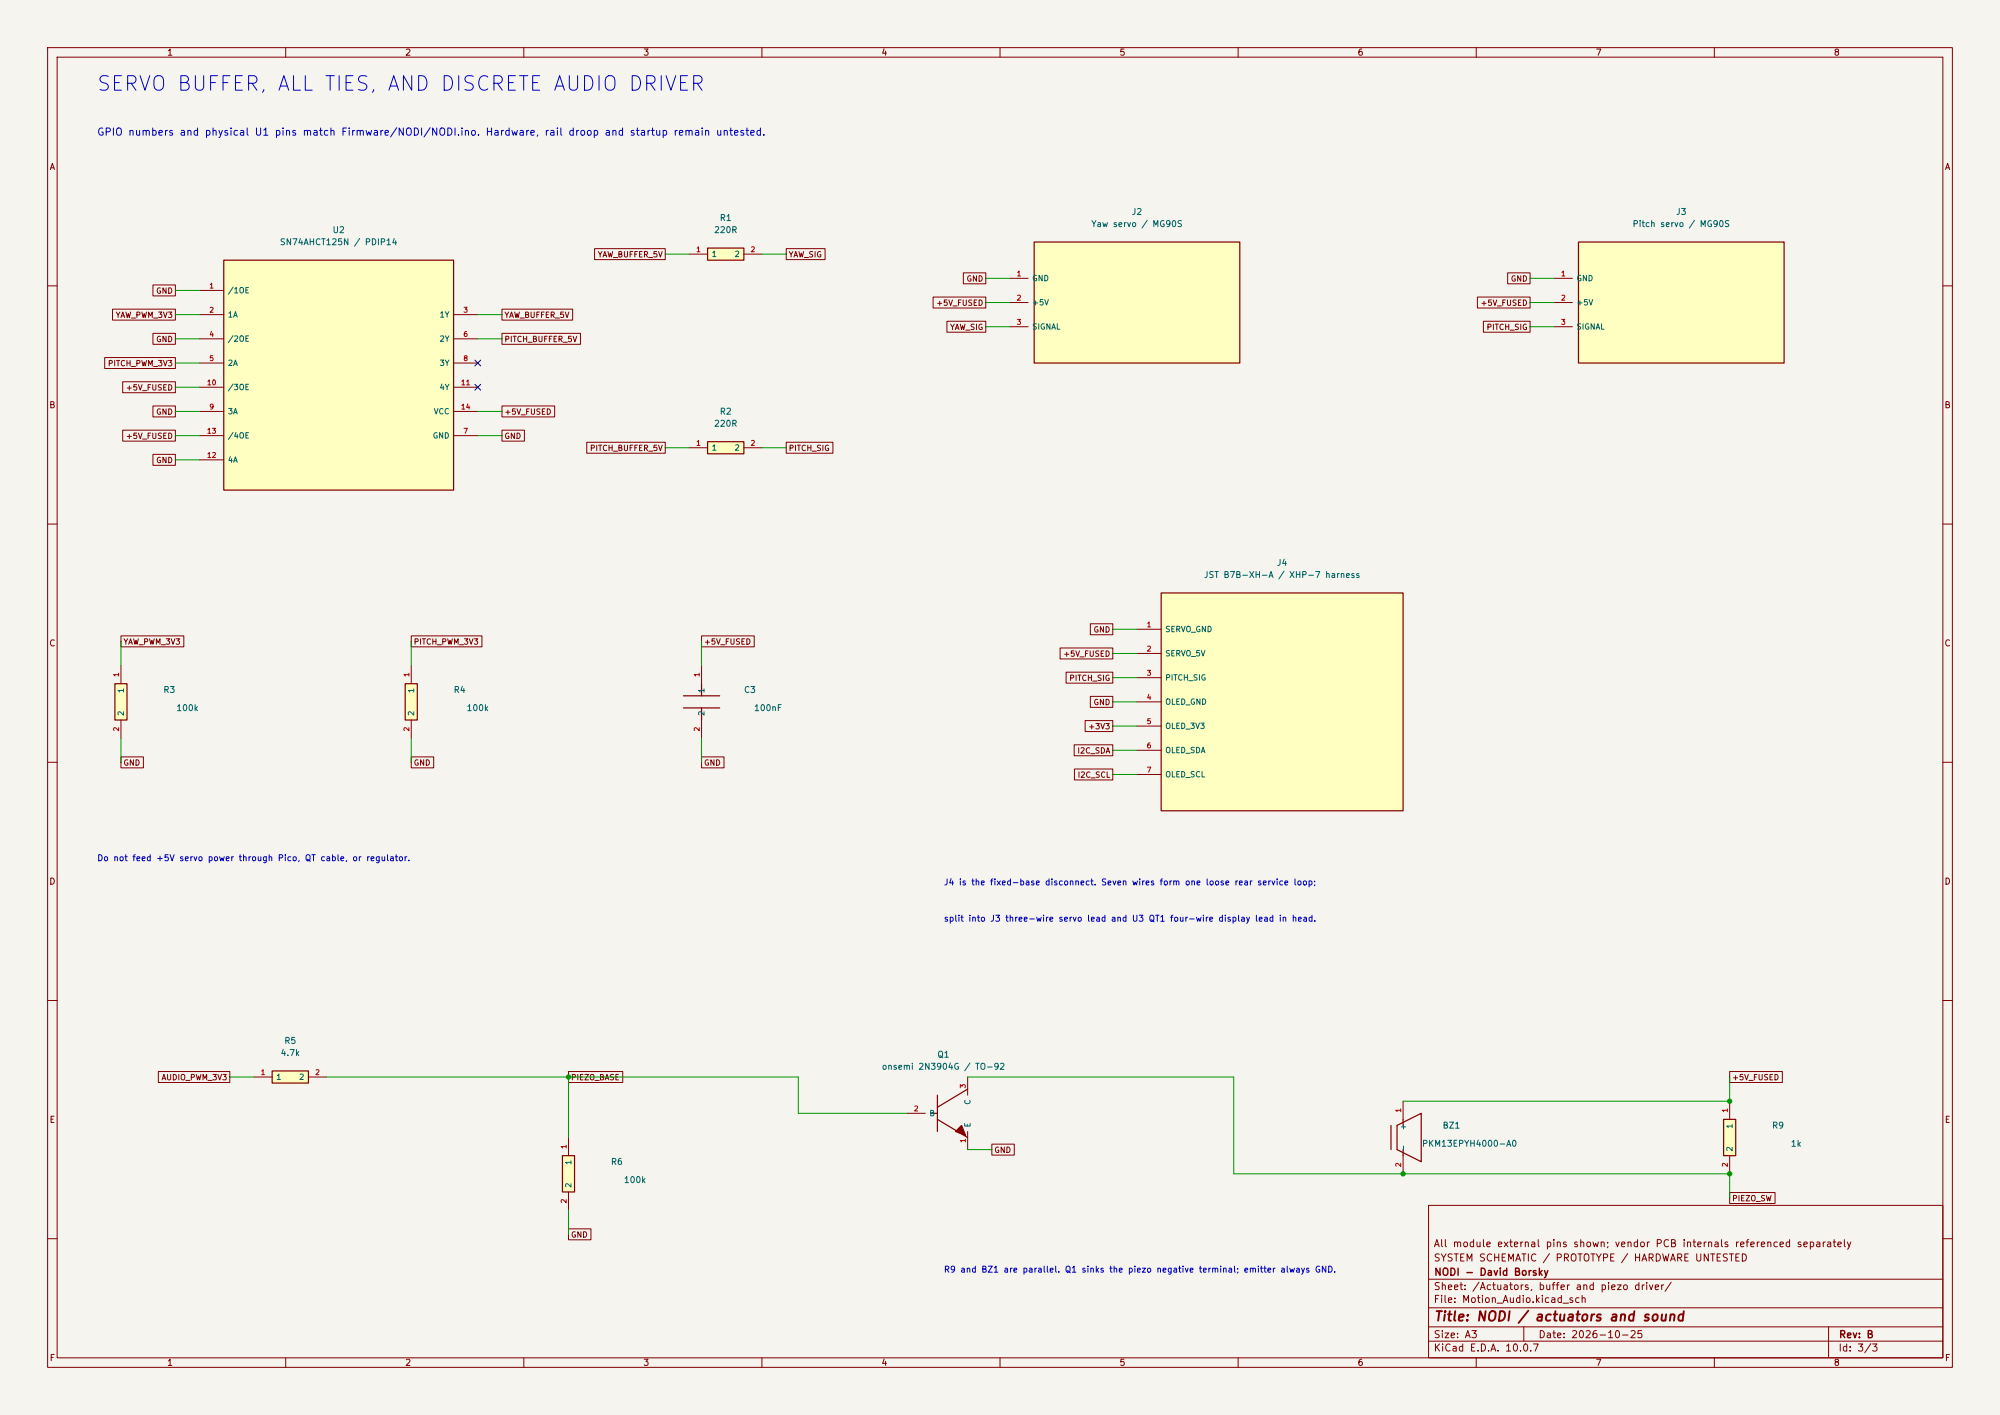
[picture p47: page 3]

SERVO BUFFER, ALL TIES, AND DISCRETE AUDIO DRIVER

GPIO numbers and physical U1 pins match Firmware/NODI/NODI.ino. Hardware, rail droop and startup remain untested.

JST B7B-XH-A / XHP-7 harness

split into J3 three-wire servo lead and U3 QT1 four-wire display lead in head. R9 and BZ1 are parallel. Q1 sinks the piezo negative terminal; emitter always GND. Do not feed +5V servo power through Pico, QT cable, or regulator.

J4 is the fixed-base disconnect. Seven wires form one loose rear service loop;

All module external pins shown; vendor PCB internals referenced separately
SYSTEM SCHEMATIC / PROTOTYPE / HARDWARE UNTESTED
NODI - David Borsky
Sheet: /Actuators, buffer and piezo driver/
File: Motion_Audio.kicad_sch
Title: NODI / actuators and sound
