DavidBorsky/NODI-Robotic-Alarm-Clock/Electronics/Schematics/Controller_Interfaces.kicad_sch

## KiCad design Electronics/Schematics/Controller_Interfaces.kicad_sch (2026-10-26)

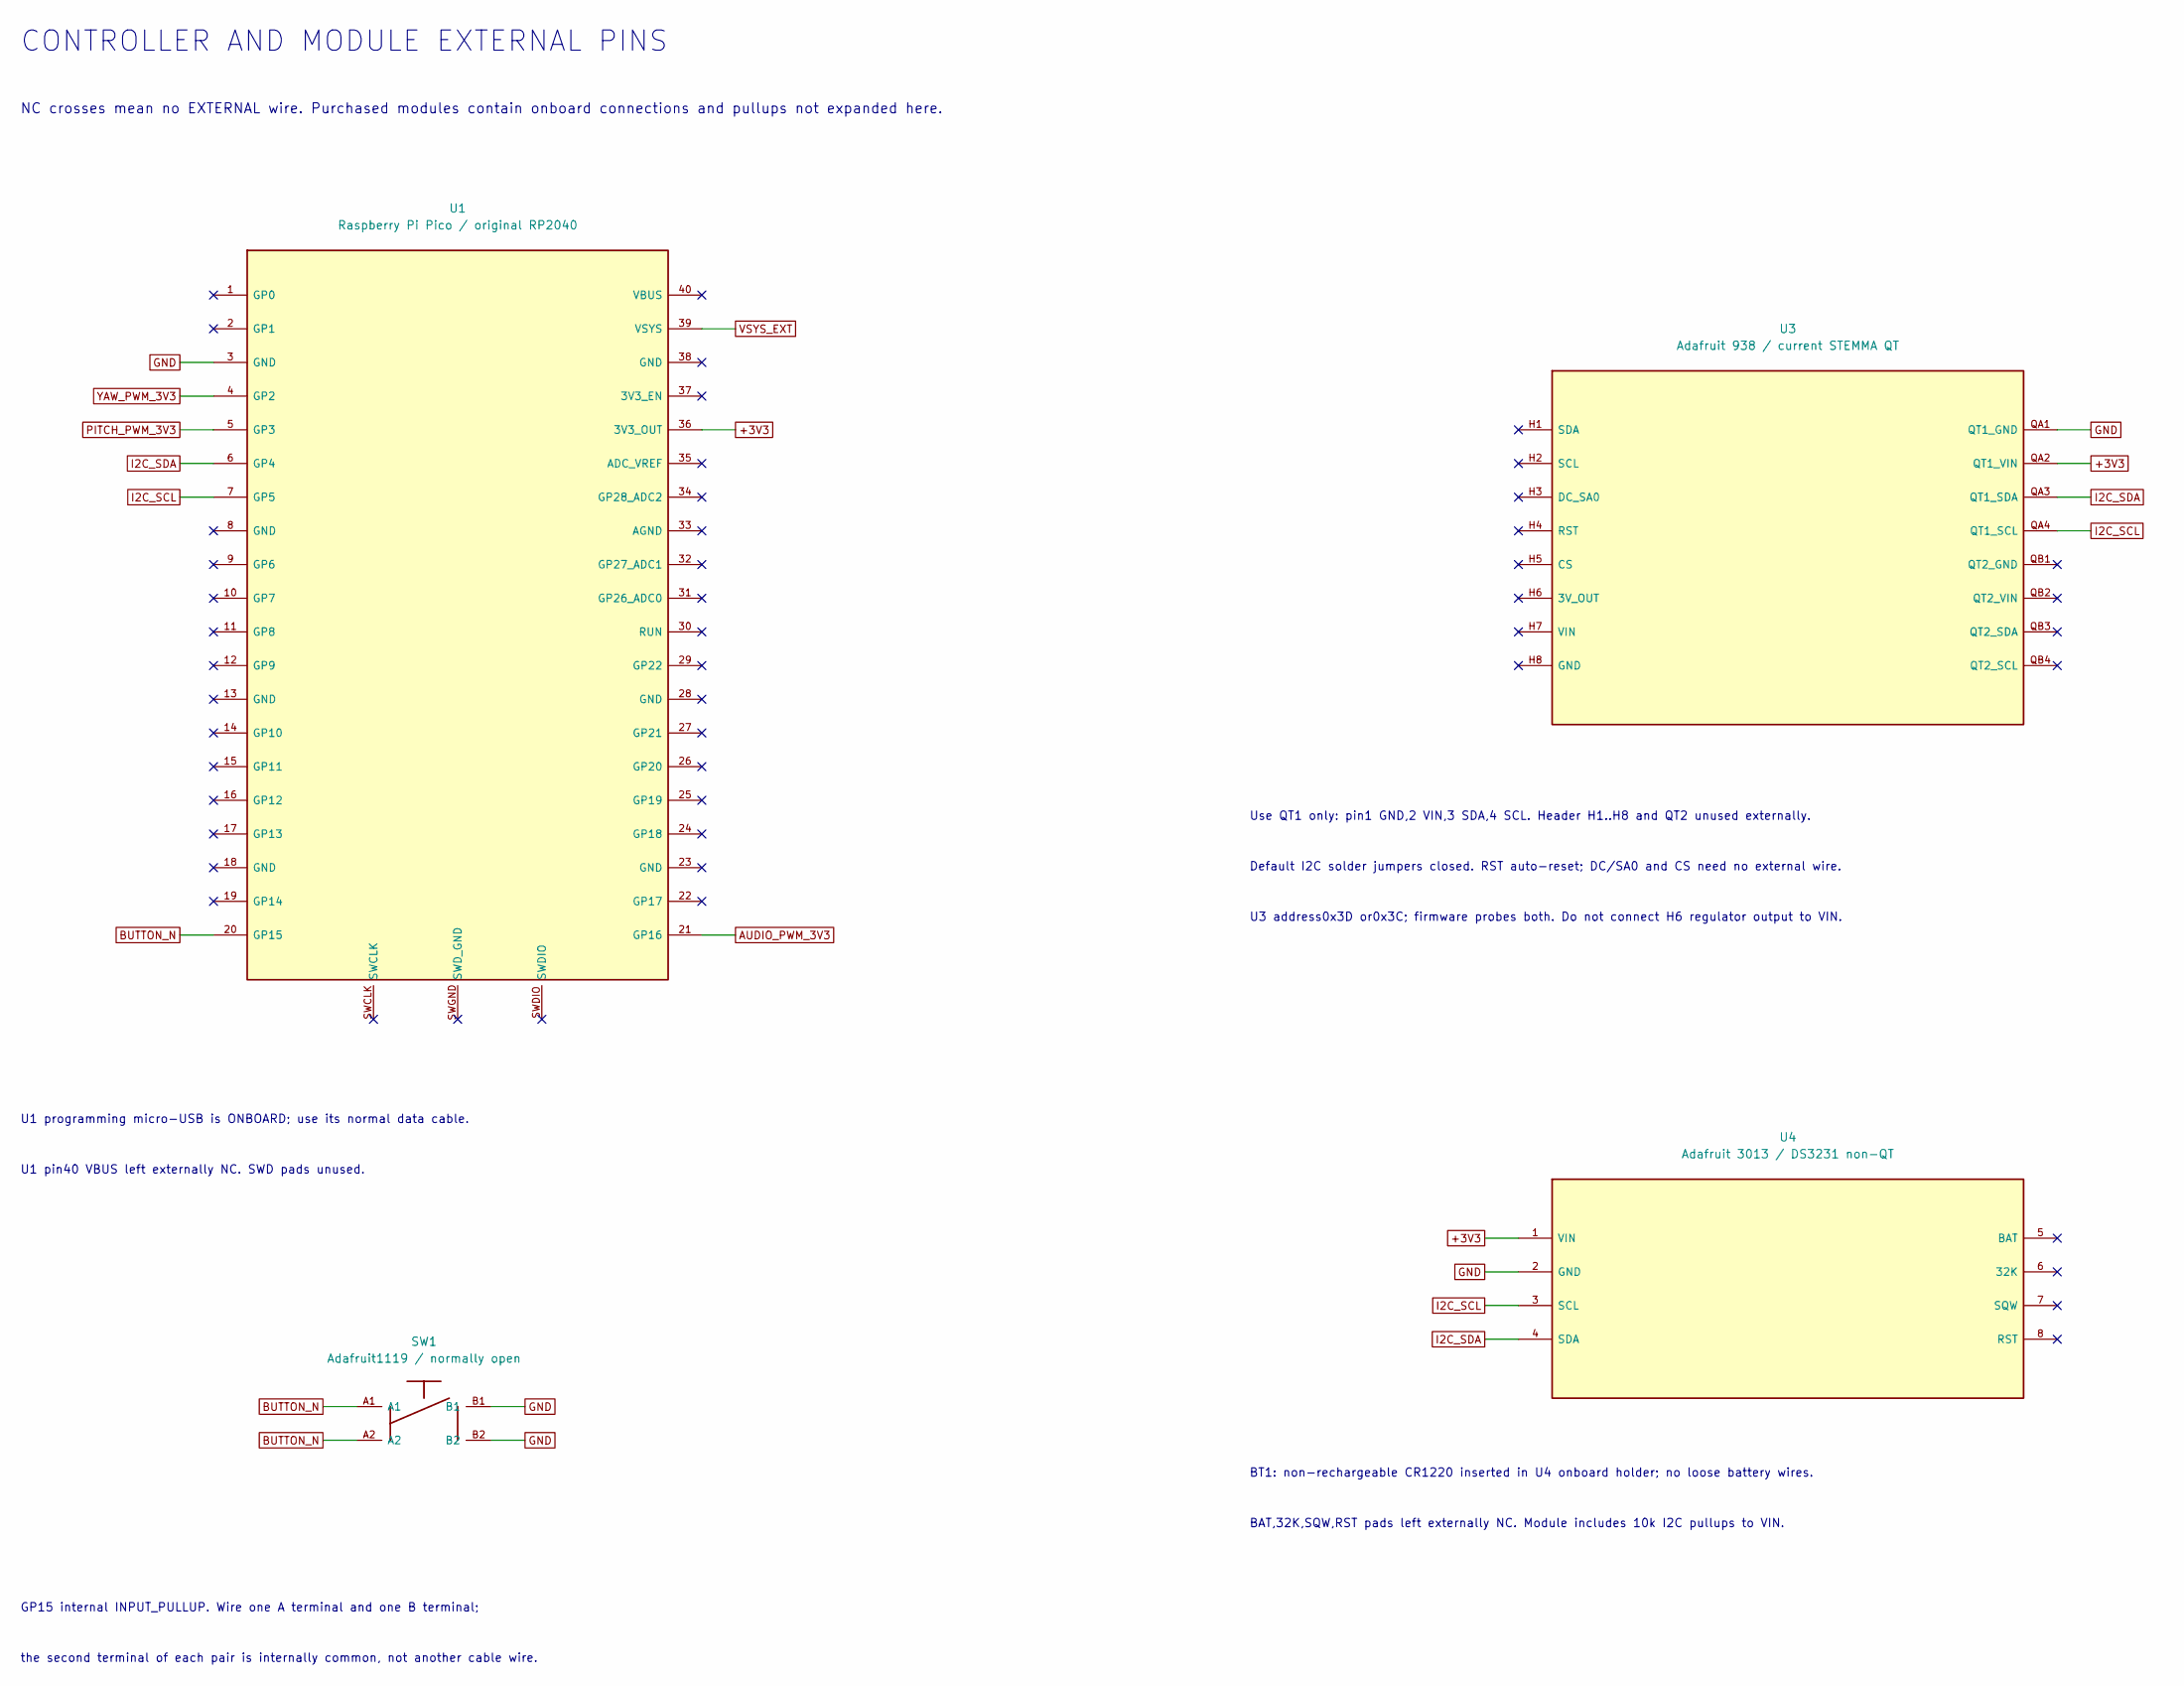
[picture p50: schematic Controller_Interfaces.kicad_sch]

Parts:
SW1: Adafruit1119 / normally open
U1: Raspberry Pi Pico / original RP2040
U3: Adafruit 938 / current STEMMA QT
U4: Adafruit 3013 / DS3231 non-QT

Connections:
+3V3: U1.36 (3V3_OUT), U3.QA2 (QT1_VIN), U4.1 (VIN)
AUDIO_PWM_3V3: U1.21 (GP16)
BUTTON_N: SW1.A1, SW1.A2, U1.20 (GP15)
GND: SW1.B1, SW1.B2, U1.3 (GND), U3.QA1 (QT1_GND), U4.2 (GND)
I2C_SCL: U1.7 (GP5), U3.QA4 (QT1_SCL), U4.3 (SCL)
I2C_SDA: U1.6 (GP4), U3.QA3 (QT1_SDA), U4.4 (SDA)
PITCH_PWM_3V3: U1.5 (GP3)
VSYS_EXT: U1.39 (VSYS)
YAW_PWM_3V3: U1.4 (GP2)

Notes on the sheet:
CONTROLLER AND MODULE EXTERNAL PINS
NC crosses mean no EXTERNAL wire. Purchased modules contain onboard connections and pullups not expanded here.
U1 programming micro-USB is ONBOARD; use its normal data cable.
U1 pin40 VBUS left externally NC. SWD pads unused.
Use QT1 only: pin1 GND,2 VIN,3 SDA,4 SCL. Header H1..H8 and QT2 unused externally.
Default I2C solder jumpers closed. RST auto-reset; DC/SA0 and CS need no external wire.
U3 address0x3D or0x3C; firmware probes both. Do not connect H6 regulator output to VIN.
BT1: non-rechargeable CR1220 inserted in U4 onboard holder; no loose battery wires.
BAT,32K,SQW,RST pads left externally NC. Module includes 10k I2C pullups to VIN.
GP15 internal INPUT_PULLUP. Wire one A terminal and one B terminal;
the second terminal of each pair is internally common, not another cable wire.
