DavidBorsky/NODI-Robotic-Alarm-Clock/Electronics/Schematics/Motion_Audio.kicad_sch

## KiCad design Electronics/Schematics/Motion_Audio.kicad_sch (2026-10-26)

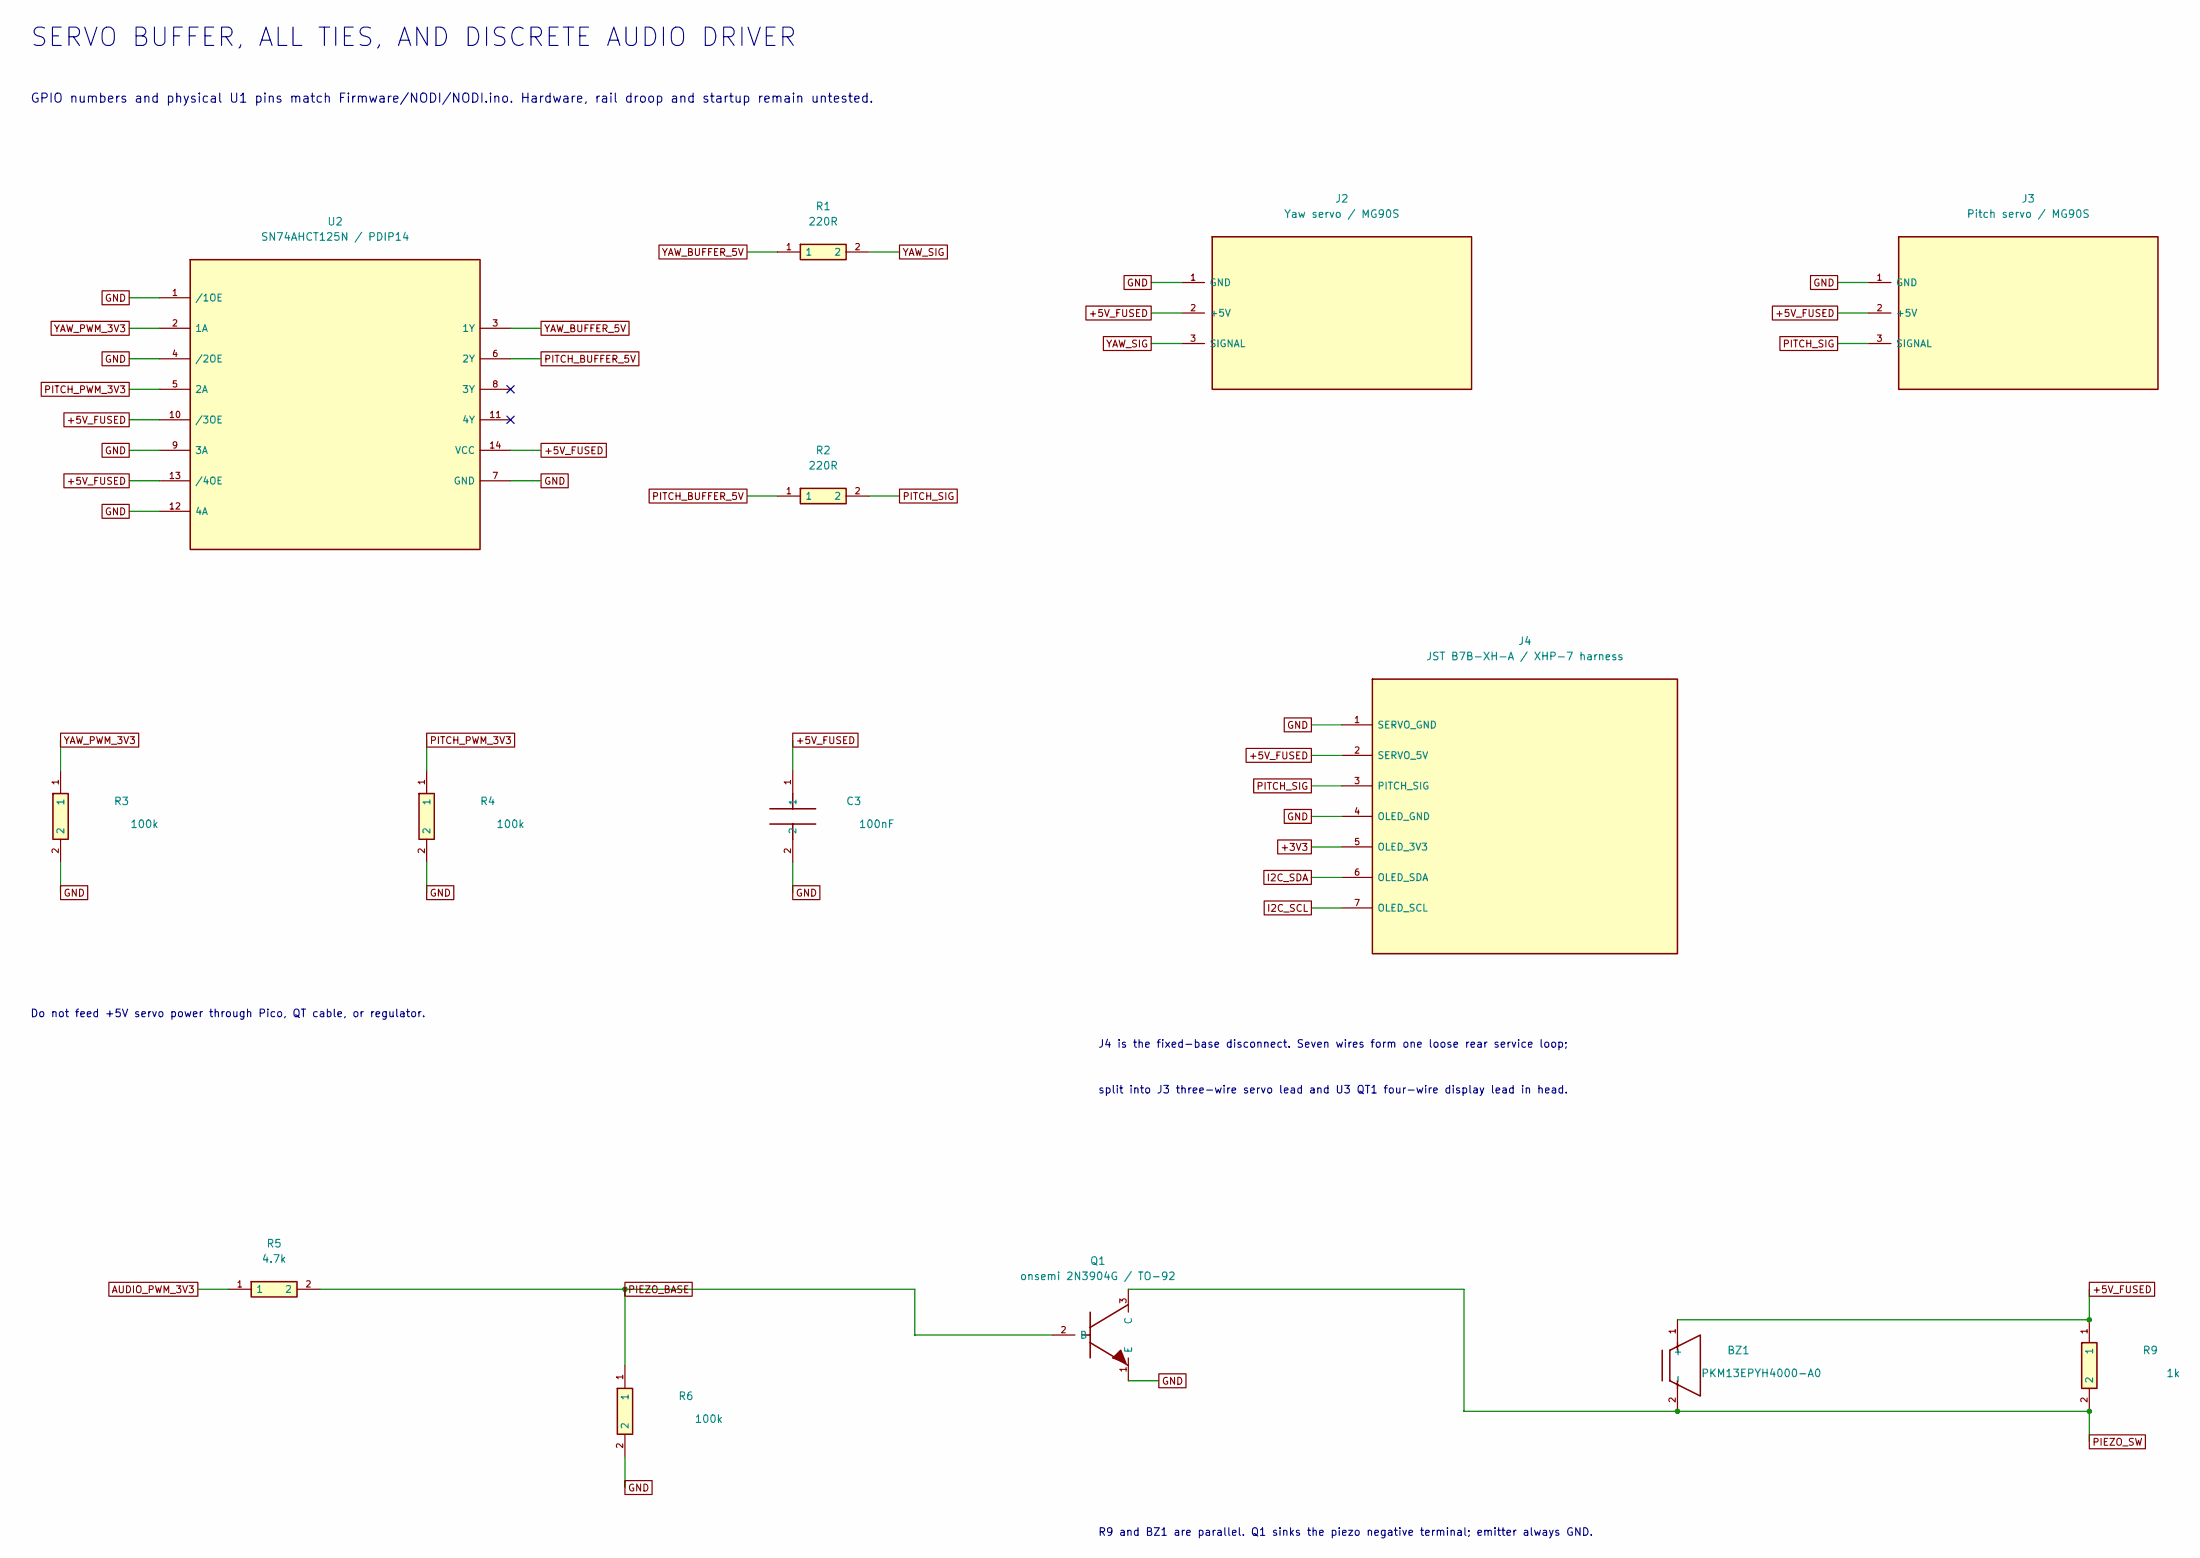
[picture p51: schematic Motion_Audio.kicad_sch]

Parts:
BZ1: PKM13EPYH4000-A0
C3: 100nF
J2: Yaw servo / MG90S
J3: Pitch servo / MG90S
J4: JST B7B-XH-A / XHP-7 harness
Q1: onsemi 2N3904G / TO-92
R1, R2: 220R
R3, R4, R6: 100k
R5: 4.7k
R9: 1k
U2: SN74AHCT125N / PDIP14

Connections:
+3V3: J4.5 (OLED_3V3)
+5V_FUSED: BZ1.1 (+), C3.1, J2.2 (+5V), J3.2 (+5V), J4.2 (SERVO_5V), R9.1, U2.10 (/3OE), U2.13 (/4OE), U2.14 (VCC)
AUDIO_PWM_3V3: R5.1
GND: C3.2, J2.1 (GND), J3.1 (GND), J4.1 (SERVO_GND), J4.4 (OLED_GND), Q1.1 (E), R3.2, R4.2, R6.2, U2.1 (/1OE), U2.4 (/2OE), U2.7 (GND), U2.9 (3A), U2.12 (4A)
I2C_SCL: J4.7 (OLED_SCL)
I2C_SDA: J4.6 (OLED_SDA)
PIEZO_BASE: Q1.2 (B), R5.2, R6.1
PIEZO_SW: BZ1.2 (-), Q1.3 (C), R9.2
PITCH_BUFFER_5V: R2.1, U2.6 (2Y)
PITCH_PWM_3V3: R4.1, U2.5 (2A)
PITCH_SIG: J3.3 (SIGNAL), J4.3 (PITCH_SIG), R2.2
YAW_BUFFER_5V: R1.1, U2.3 (1Y)
YAW_PWM_3V3: R3.1, U2.2 (1A)
YAW_SIG: J2.3 (SIGNAL), R1.2

Notes on the sheet:
SERVO BUFFER, ALL TIES, AND DISCRETE AUDIO DRIVER
GPIO numbers and physical U1 pins match Firmware/NODI/NODI.ino. Hardware, rail droop and startup remain untested.
J4 is the fixed-base disconnect. Seven wires form one loose rear service loop;
split into J3 three-wire servo lead and U3 QT1 four-wire display lead in head.
Do not feed +5V servo power through Pico, QT cable, or regulator.
R9 and BZ1 are parallel. Q1 sinks the piezo negative terminal; emitter always GND.
