DavidBorsky/NODI-Robotic-Alarm-Clock/Electronics/Schematics/NODI_System_RevB.kicad_sch

## KiCad design Electronics/Schematics/NODI_System_RevB.kicad_sch (2026-10-26)

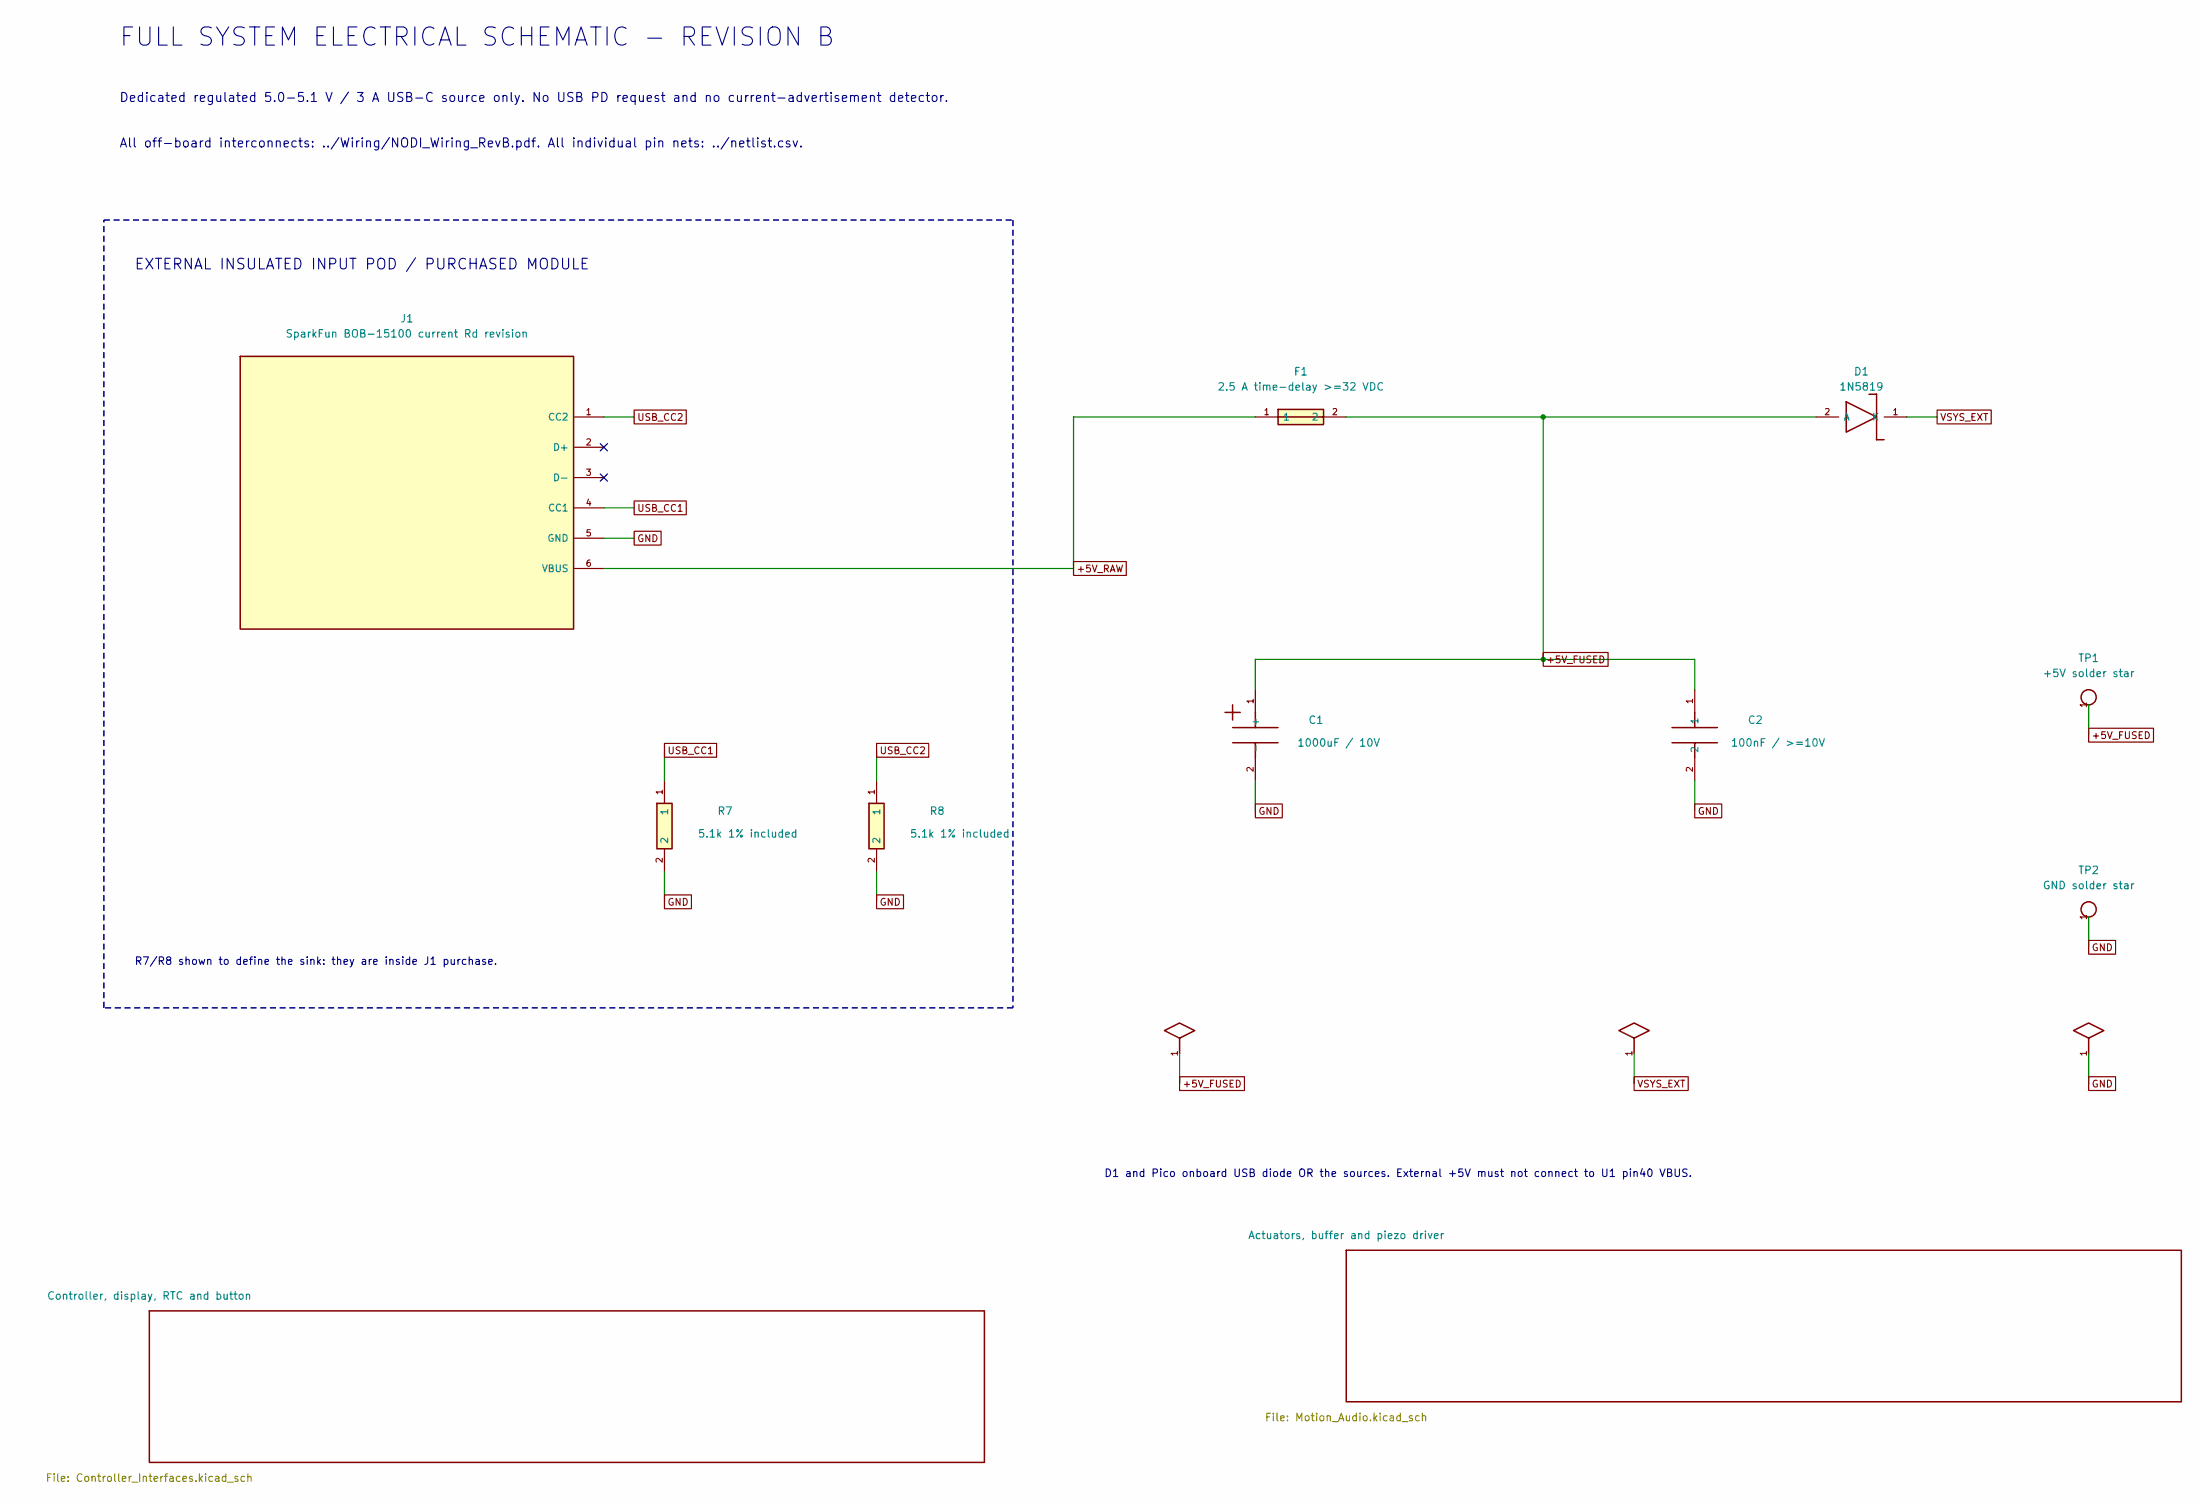
[picture p52: schematic NODI_System_RevB.kicad_sch]

Parts:
C1: 1000uF / 10V
C2: 100nF / >=10V
D1: 1N5819
F1: 2.5 A time-delay >=32 VDC
J1: SparkFun BOB-15100 current Rd revision
R7, R8: 5.1k 1% included
TP1: +5V solder star
TP2: GND solder star

Connections:
+5V_FUSED: C1.1 (+), C2.1, D1.2 (A), F1.2, TP1.1
+5V_RAW: F1.1, J1.6 (VBUS)
GND: C1.2 (-), C2.2, J1.5 (GND), R7.2, R8.2, TP2.1
USB_CC1: J1.4 (CC1), R7.1
USB_CC2: J1.1 (CC2), R8.1
VSYS_EXT: D1.1 (K)

Notes on the sheet:
FULL SYSTEM ELECTRICAL SCHEMATIC - REVISION B
Dedicated regulated 5.0-5.1 V / 3 A USB-C source only. No USB PD request and no current-advertisement detector.
All off-board interconnects: ../Wiring/NODI_Wiring_RevB.pdf. All individual pin nets: ../netlist.csv.
EXTERNAL INSULATED INPUT POD / PURCHASED MODULE
R7/R8 shown to define the sink: they are inside J1 purchase.
D1 and Pico onboard USB diode OR the sources. External +5V must not connect to U1 pin40 VBUS.
