DavidBorsky/NODI-Robotic-Alarm-Clock/(commit log)

2026-10-25 Create NODI revision A engineering portfolio with verified CAD and controls
    [BOM.csv, NODI-P01_base_cup.stl, NODI-P02_base_deck.stl, NODI-P03_yoke.stl, NODI-P04_head_shell.stl, NODI-P05_front_bezel.stl, NODI-P06_rear_carrier.stl, NODI-P07_power_carrier.stl]
2026-10-25 Keep generated CAD binary in diffs and normalize table line endings
    [motion_profile.csv]
2026-10-26 Add complete electrical schematics and constrained mechanism model
    [BOM.csv, Controller_Interfaces.kicad_sch, Motion_Audio.kicad_sch, NODI_Articulated_RevA.blend, NODI_Articulated_RevA.urdf, NODI_System_RevB.kicad_sch, electronics_BOM.csv, netlist.csv]
